azuresky2019/Bacnet_Transducer/DOC/pics/pwm wiring_web.jpg

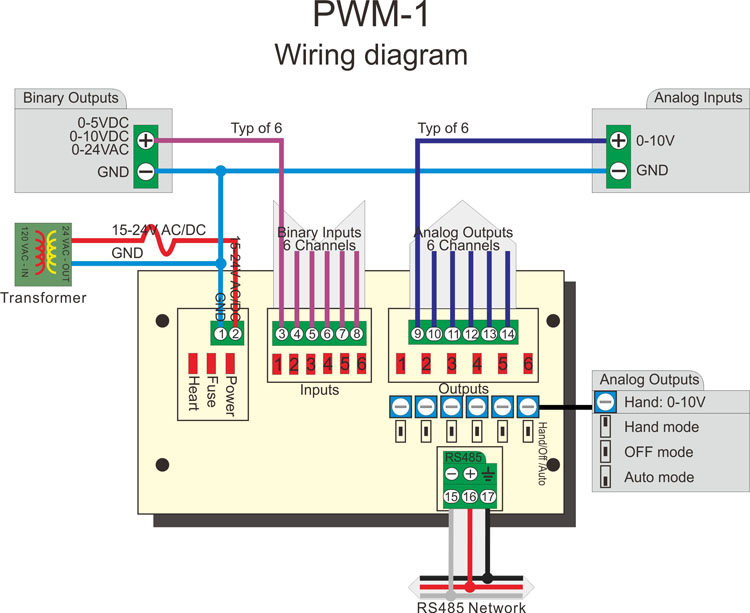
DOC/pics/pwm wiring_web.jpg
