azuresky2019/Bacnet_Transducer/DOC/pics/pwm_web_thumbnail.jpg

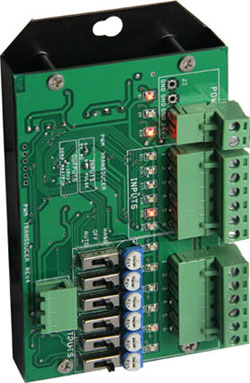
DOC/pics/pwm_web_thumbnail.jpg
