azuresky2019/Bacnet_Transducer/README.md

# Bacnet_Transducer
Bacnet transducer, converts binary output to analog outputs. Also can be used as general purpose Bacnet i/o.
