azuresky2019/Bacnet_Transducer/DOC/pics/2.jpg

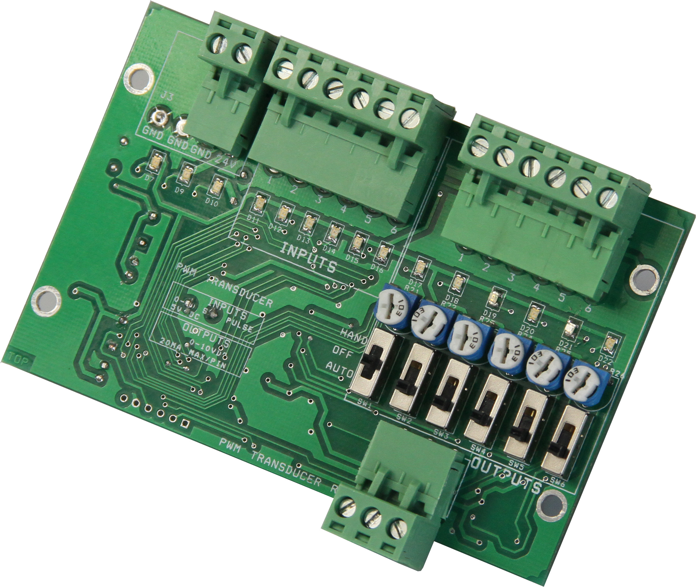
DOC/pics/2.jpg
