azuresky2019/Bacnet_Transducer/DOC/pics/6.jpg

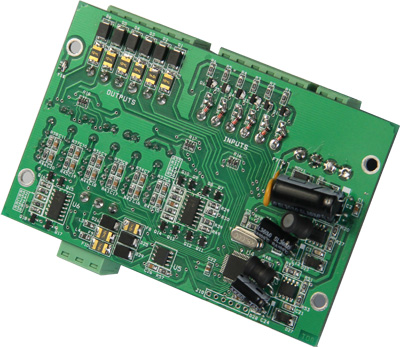
DOC/pics/6.jpg
