azuresky2019/Bacnet_Transducer/DOC/pics/55-2.jpg

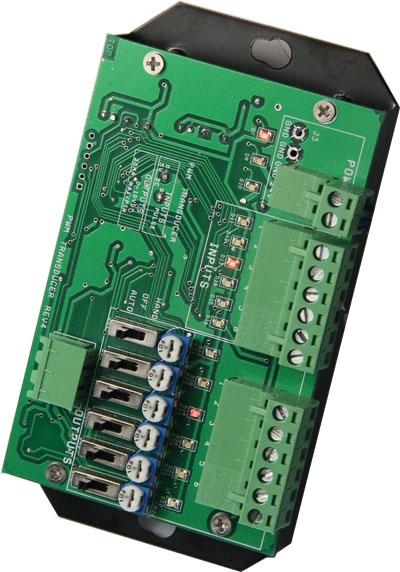
DOC/pics/55-2.jpg
