azuresky2019/Bacnet_Transducer/DOC/pics/PWM0.jpg

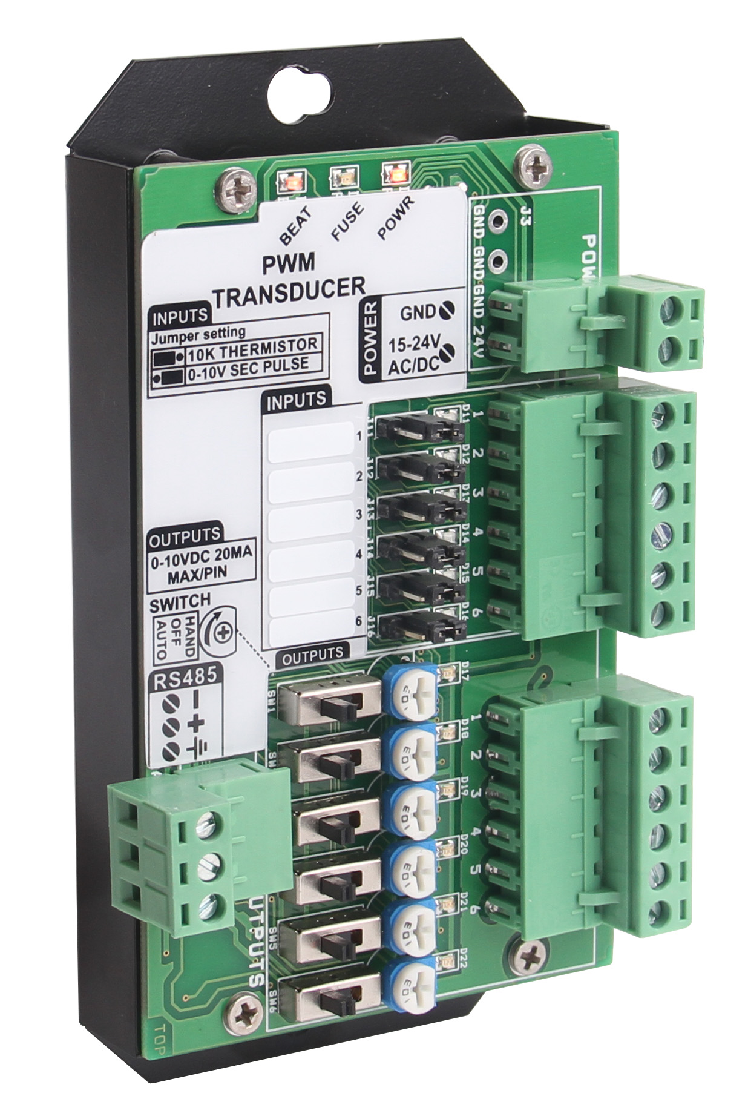
DOC/pics/PWM0.jpg
