azuresky2019/Bacnet_Transducer/DOC/pics/PWM2.jpg

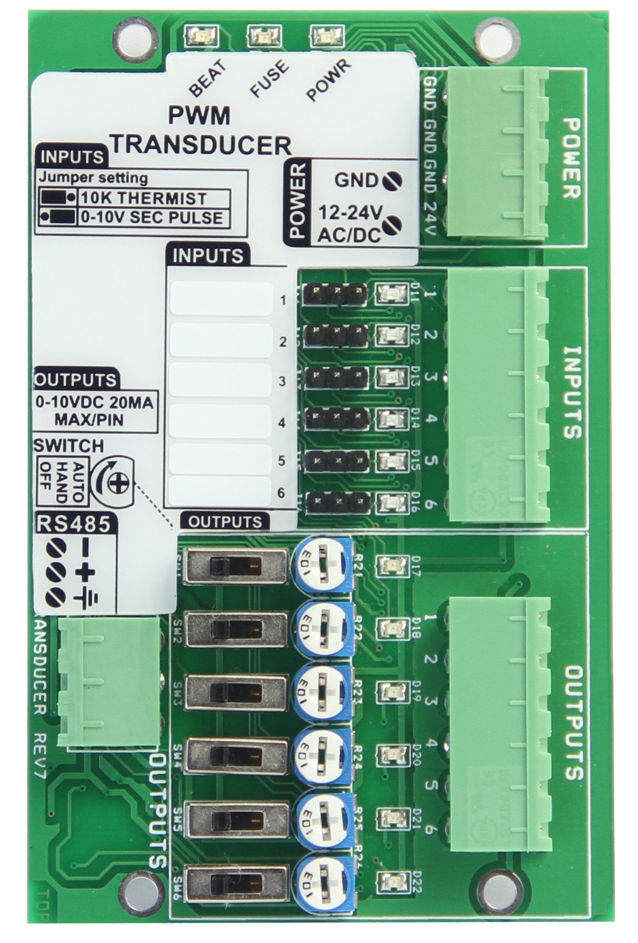
DOC/pics/PWM2.jpg
