azuresky2019/Bacnet_Transducer/DOC/pics/pwm dimensions.jpg

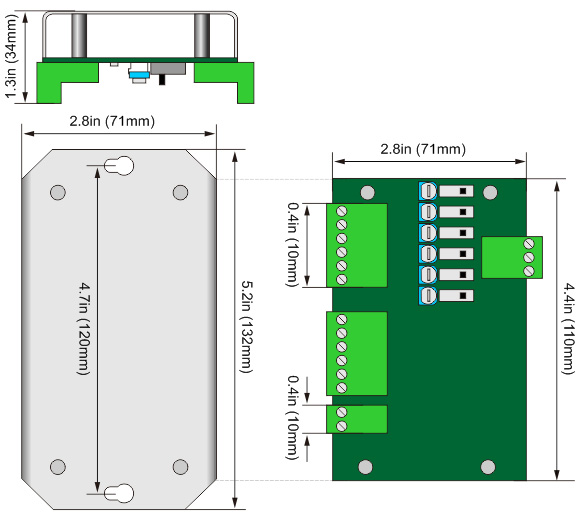
DOC/pics/pwm dimensions.jpg
