azuresky2019/Bacnet_Transducer/DOC/pics/PWM.jpg

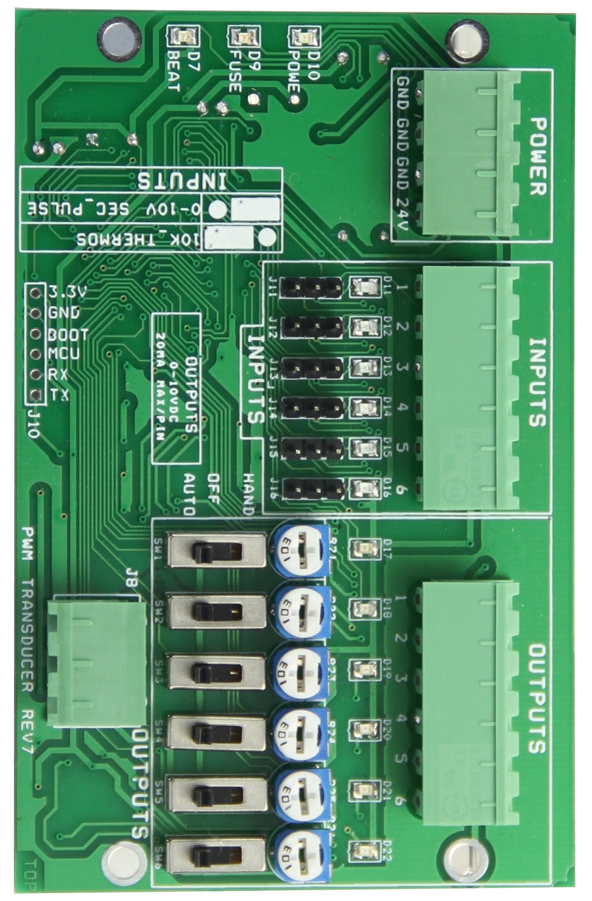
DOC/pics/PWM.jpg
