azuresky2019/Bacnet_Transducer/DOC/pics/PWM_front.jpg

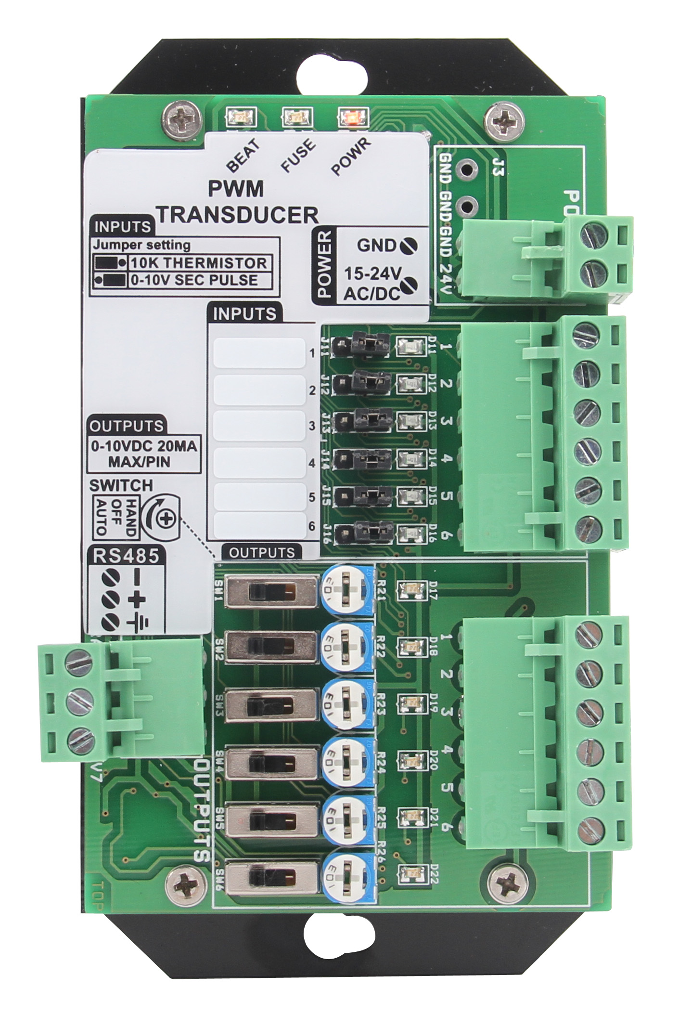
DOC/pics/PWM_front.jpg
