azuresky2019/Bacnet_Transducer/DOC/pics/PWM_left.png

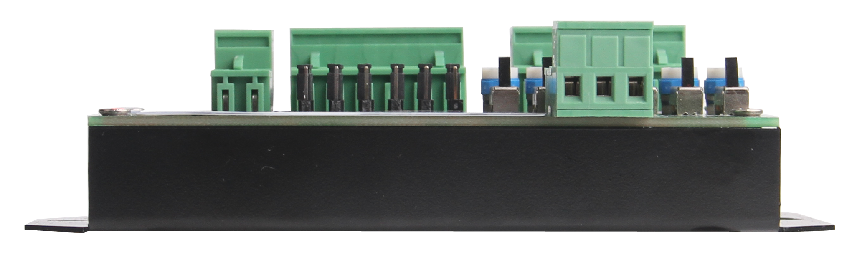
DOC/pics/PWM_left.png
