azuresky2019/Bacnet_Transducer/DOC/pics/PWM_s.png

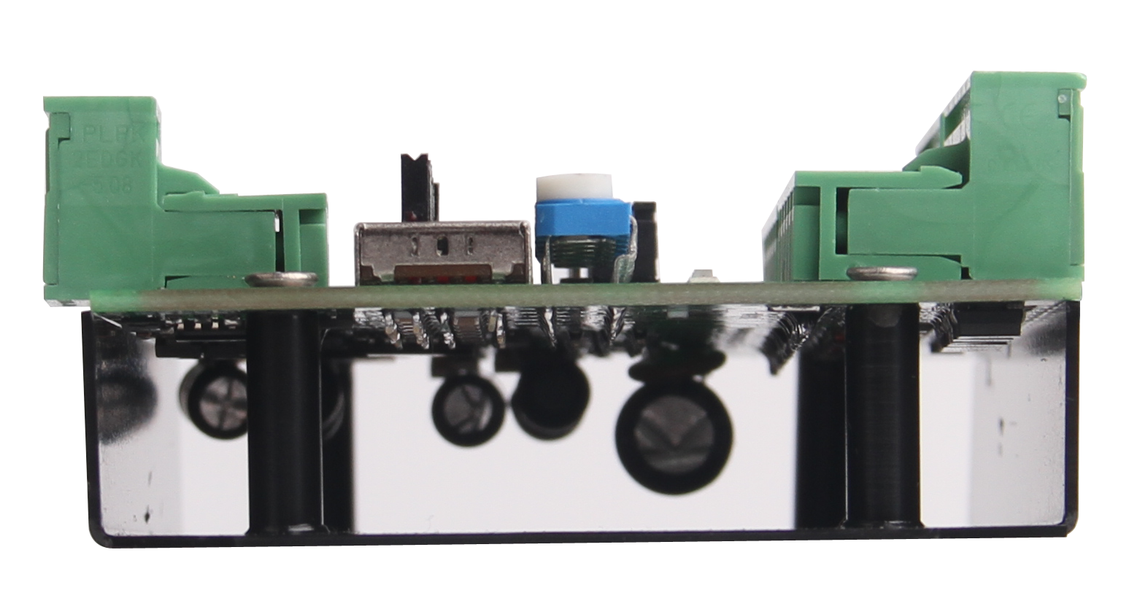
DOC/pics/PWM_s.png
