azuresky2019/Bacnet_Transducer/DOC/pics/PWM_view.jpg

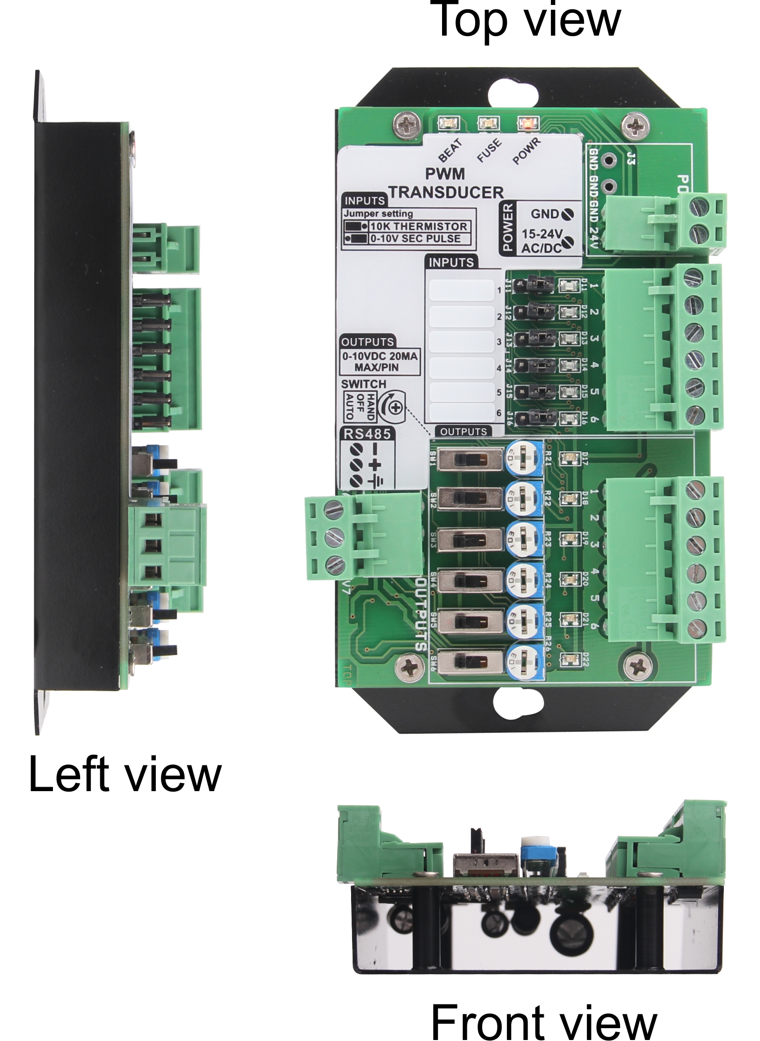
DOC/pics/PWM_view.jpg
