azuresky2019/Bacnet_Transducer/Hardware/PWM_Rev7/PWM_Rev7.xlsx

Z:\Designs\TransducerVolts\Hardware\PWM_Rev7
Bill Of Materials October 17,2016 9:18:17
Itm | Qty | Reference | Value | PCB Footprint | Description | Tle | Part_Number
______________________________________________
1 | 16 | C1,C13,C14,C15,C16,C17,C18,C19, | 0.1UF_50V | SM/C_0805 |  | 10% | 0.1UF_50V_0805
 |  | C20,C23,C26,C27,C28,C29,C30,C33
2 | 1 | C2 | 470UF_50V | CPCYLHORIZ/D.400/LS.200/.034 |  | 20% | 470UF_50V_DIP
3 | 2 | C3,C21 | 220PF_50V | SM/C_0805 |  | 10% | 220PF_50V_0805
4 | 6 | C6,C7,C8,C9,C10,C11 | 1UF_50V | Designs\Lib\CAP.LLB\SM/C_0805 |  | 10% | 1UF_50V_0805
5 | 1 | C12 | 100UF_25V | CPCYLHORIZ/D.200/LS.100/.034 |  | 20% | 100UF_25V_DIP
6 | 1 | C24 | 330UF_16V | CPCYLHORIZ/D.200/LS.100/.034 |  | 20% | 330UF_16V_DIP
7 | 1 | C31 | 10UF_16V | SM/C_TANT |  |  | 10UF_16V_TANT
8 | 1 | C39 | 100UF_7V | SM/C_TANT |  | 10% | 100UF_7V_TANT
9 | 6 | D1,D2,D3,D4,D5,D6 | SMBJ12CA | SM/MOV40V | V(RWM)=12V |  | SMBJ12CA
10 | 8 | D7,D10,D17,D18,D19,D20,D21,D22 | LED_RED_0805 | SM/D_0805_21 |  |  | LED_RED_0805
11 | 1 | D8 | 1N4007 | SM/D_MLL41_21 | VRRM=1000V |  | 1N4007
12 | 1 | D9 | LED_GREEN_0805 | SM/D_0805_21 |  |  | LED_GREEN_0805
13 | 6 | D11,D12,D13,D14,D15,D16 | LED_BLUE_0603 | SM/D_0603 |  |  | LED_BLUE_0603
14 | 2 | D23,D27 | 1N5819 | SM/D_MLL41_21 | V(RMS)=28V |  | 1N5819
15 | 1 | D24 | 1N4744 | SM/D_1206_21 | VZ=15V |  | 1N4744_15V_1206
16 | 3 | D25,D26,D29 | SMBJ10CA | SM/MOV40V | V(RWM)=10V |  | SMBJ10CA
17 | 1 | D28 | 1N4729 | SM/D_1206_21 | VZ=3.6V |  | 1N4729
18 | 6 | D30,D31,D32,D33,D34,D35 | 1N4148 | SM/D_1206 | Fast Switching Diodes |  | 1N4148_1206
19 | 1 | D36 | CJ431_SOT | SM/SOT23_123 | JIANGSU CHANGJIANG |  | CJ431_SOT
20 | 6 | D37,D38,D39,D41,D42,D43 | 1N4729 | SM/D_1206_21 | VZ=3.6V |  | 1N4729
21 | 9 | F1,F2,F3,F4,F5,F6,F8,F9,F10 | 0.1A_60V | SM/FUSE_1812 | MF-MSMF Series - PTC Resettable Fuses |  | MF-MSMF010
22 | 1 | F7 | 0.65A_60V | RAD/.250X.125/LS.200/.034 | LP60 series |  | LP60-065
23 | 1 | J3 | ETB4_5.08_90_GREEN | ETB4INCH | Pitch=5.08mm,single,male,90¡ã,Green,Pluggable |  | ETB4_5.08_90_GREEN
24 | 2 | J4,J5 | ETB6_5.08_90_GREEN | ETB6INCH | Pitch=5.08mm,single,male,90¡ã,Green,Pluggable |  | ETB6_5.08_90_GREEN
25 | 1 | J6 | Tiepoint | GROUNDS_REV1 | solder_metal_wire |  | Tiepoint
26 | 1 | J8 | ETB3_5.08_90_GREEN | ETB3INCH | Pitch=5.08mm,single,male,90¡ã,Green,Pluggable |  | ETB3_5.08_90_GREEN
27 | 1 | J10 | Header6_2.54_180 | HEADER6_2.54 | Pitch=2.54mm, single,male,180¡ã |  | Header6_2.54_180
28 | 6 | J11,J12,J13,J14,J15,J16 | Header3_2.54_180 | HEADER3_2.54 | Pitch=2.54mm, single,male,180¡ã |  | Header3_2.54_180
29 | 2 | L1,L2 | 330uH_1A_SMALL | L/330UH | 0608,1A,330UH |  | 330uH_1A_SMALL
30 | 2 | L3,L4 | 0.3A_1K | SM/C_0805 | 0.3A_1K_100MHZ |  | 0.3A_1K
31 | 1 | L5 | 47uH | SM/L_0805 |  |  | 47uH
32 | 1 | MOV1 | SMBJ36CA | SM/MOV40V | V(RWM)=36V |  | SMBJ36CA
33 | 12 | Q1,Q2,Q3,Q4,Q5,Q6,Q8,Q10,Q12,Q13, | 2N2222 | SM/SOT23_123 |  |  | 2N2222
 |  | Q16,Q18
34 | 6 | Q7,Q9,Q11,Q14,Q15,Q17 | 2N2907 | SM/SOT23_123 |  |  | 2N2907
35 | 24 | R1,R2,R3,R4,R5,R6,R7,R8,R9,R10,R11, | 10K_0805 | SM/R_0805 |  | 1% | 10K_0805
 |  | R12,R65,R66,R67,R68,R69,R70,R71,R72,
 |  | R73,R74,R81,R82
36 | 1 | R13 | 470R_0805 | SM/R_0805 |  | 1% | 470R_0805
37 | 3 | R14,R15,R89 | 1K_0805 | SM/R_0805 |  | 1% | 1K_0805
38 | 3 | R16,R17,R18 | 200R_4P | SM/R_1608_NET4 |  |  | 200R_4P
39 | 2 | R19,R47 | 0.5R_1206 | SM/R_1206 |  | 1% | 0.5R_1206
40 | 1 | R20 | 16.9K_0805 | SM/R_0805 |  | 1% | 16.9K_0805
41 | 6 | R21,R22,R23,R24,R25,R26 | 10K_VAR |  | 3pins£¬10K VAR ,VC1000 |  | 10K_VAR
42 | 1 | R27 | 1.96K_0805 | SM/R_0805 |  | 1% | 1.96K_0805
43 | 6 | R29,R32,R49,R50,R52,R58 | 6.19K_0805 | SM/R_0805 |  | 1% | 6.19K_0805
44 | 6 | R30,R31,R39,R40,R54,R56 | 3K_0805 | SM/R_0805 |  | 1% | 3K_0805
45 | 7 | R33,R34,R35,R36,R37,R38,R57 | 4.7K_0805 | SM/R_0805 |  | 1% | 4.7K_0805
46 | 6 | R41,R42,R43,R44,R45,R46 | 47K_0805 | SM/R_0805 |  | 1% | 47K_0805
47 | 1 | R51 | 5.9K_0805 | SM/R_0805 |  | 1% | 5.9K_0805
48 | 1 | R53 | 3.6K_0805 | SM/R_0805 |  | 1% | 3.6K_0805
49 | 6 | R59,R60,R61,R62,R63,R64 | 200K_0805 | SM/R_0805 |  | 1% | 200K_0805
50 | 3 | R83,R85,R87 | 100K_0805 | SM/R_0805 |  |  | 100K_0805
51 | 1 | R84 | 0R_0805 | SM/R_0805 |  |  | 0R_0805
52 | 1 | R88 | 1.5K_2010 | SM/R_0805 | 1/2W | 1% | 1.5K_2010
53 | 1 | R90 | 4.99K_0805 | SM/R_0805 |  |  | 4.99K_0805
54 | 3 | R91,R92,R93 | 10K_0805 | SM/R_0805 |  |  | 10K_0805
55 | 6 | SW1,SW2,SW3,SW4,SW5,SW6 | SW DP3T_4 | SWSLIDESP3TC_NO_POSTHOLE | T3_8I13R_Switch |  | SW DP3T_4
56 | 2 | U1,U3 | MC34063A_SO | 8SOP150 |  |  | MC34063A_SO
57 | 2 | U2,U6 | LM324DR | 14SOP150 |  |  | LM324DR
58 | 1 | U4 | STM32F103VC | QUAD.50M/100/WG16.00 | 100PINs£¬small STM32 chip |  | STM32F103VC
59 | 1 | U5 | SN65HVD3082 | 8SOP150 |  |  | SN65HVD3082
60 | 1 | U7 | AT24C16 | 8SOP150 |  |  | AT24C16
61 | 1 | X1 | 8MHZ_SMD_3PIN | 8M_SMD_3PIN | SMD |  | 8MHZ_SMD_3PIN
