azuresky2019/Bacnet_Transducer/Hardware/PWM_Rev6/pwmrev6_1012.dxf

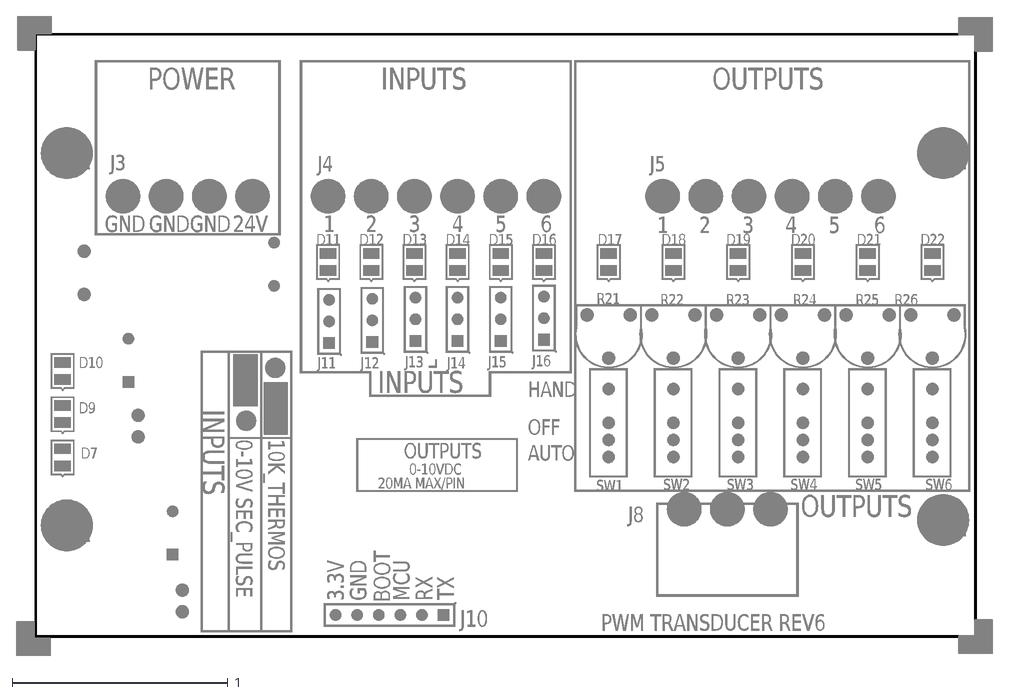
[picture p26: CAD file, 2017-04-28, an earlier design]
Hardware/PWM_Rev6/pwmrev6_1012.dxf
INPUTS
OUTPUTS
POWER
GND
24V
1
2
3
4
5
6
3.3V
AUTO
HAND
OFF
10K_THERMOS
RX
0-10VDC
20MA MAX/PIN
0-10V SEC_PULSE
PWM TRANSDUCER REV6
J2
J9
J1
J7
D17
D9
D15
D22
D13
R21
D20
J5
D11
R25
SW1
D18
SW2
R23
D16
D7
R22
D14
SW3
R24
SW5
SW4
D10
J8
J4
J3
D12
SW6
R26
D19
D21
J11
J12
J13
J14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
