azuresky2019/Bacnet_Transducer/(list of files, cad)

Other CAD files:
Hardware/PWM_Rev5/PWMREV5.dxf
