azuresky2019/Bacnet_Transducer/Hardware/PWM_Rev7/pwmrev6.pdf

## RTC POWER

## MCU DEBUG PORT

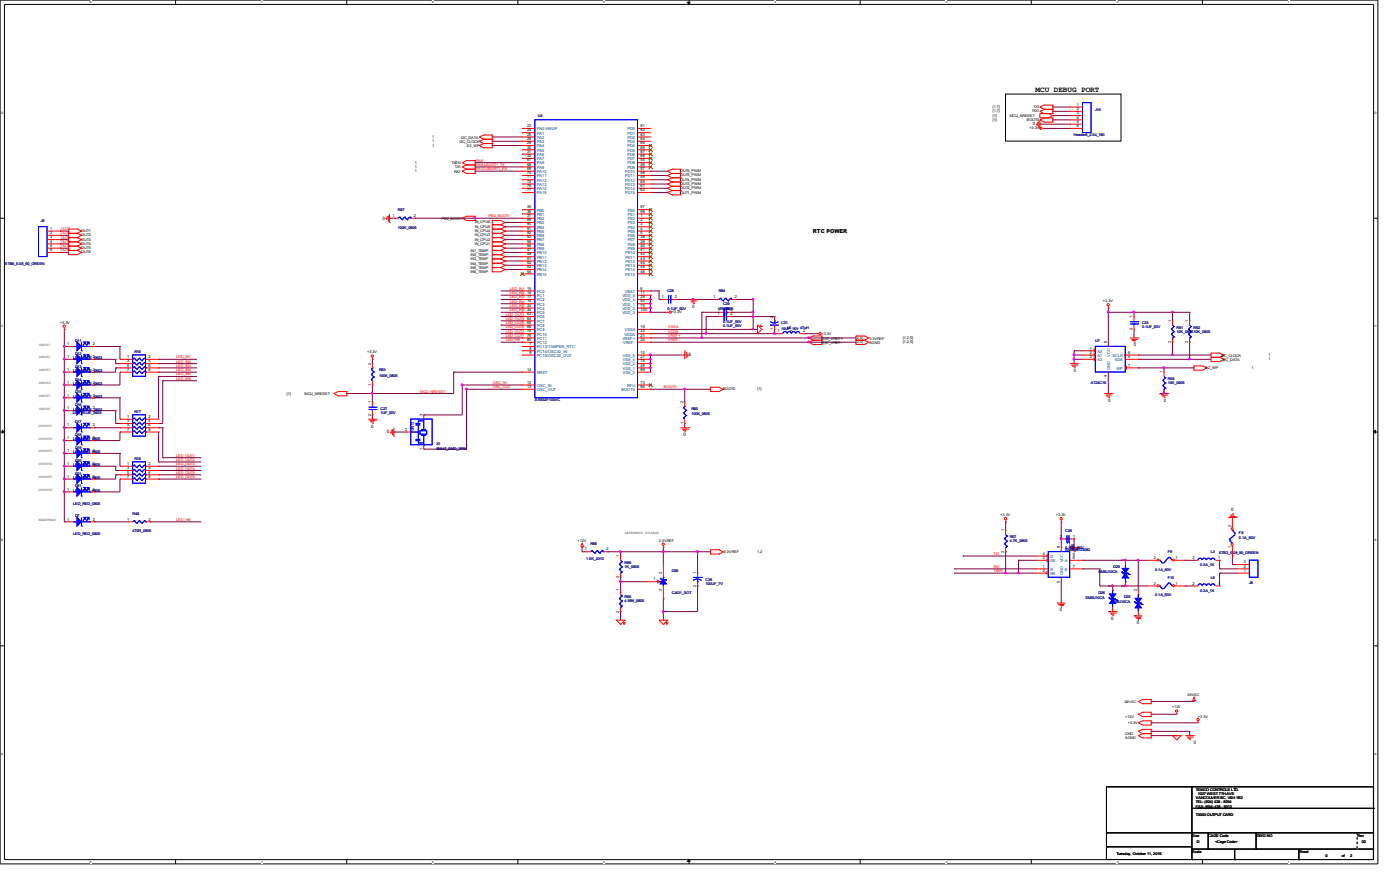
[picture p27: page 1]

5

4

3

2

1

E | E
D | D
C | C
B | B
A | A

# Original Rev for Memco

# Rev0

# Took T3-8I8O design rev14 and reworked it for PWM project

# Rev1

# Done: fix mux select lines

# Done: remove pull up on P0 lines

# Done: require a TXEN line for RS485 com, pin3.2

# Done: remove 470 current limitting resistors

# Done: move D33 to make space for pic socket

# Done: R18 and R22 to move for cpu socket

# Done: update footprint of packet resistors

# Done: flip D33

# Done: move IN_CPU2 to Port0 given the internal pull-ups may affect Analog input reads

# Done: output feedback to pic should come from 5V side of OPamp

Done: One pin of each "hand" potentiometer must be tied to GND.

# Done: Each "hand" potentiometer must be tied to 12V not 5V

# Done: Connect analog GND to INPUT page

# Done: Make sure all thru-holes have thermal relief

# Done: Outputs out of order on PCB

# Done: crystal footprint updated

# Done: changed the resistance for power to 1.89 and 5.96 for the 5V supply

# TBD: rectify footprint names of 2N2222, Q1, Q2 for BOM purposes

# Done: timing cap for power chip changed to 120pF to reduce noise

# Rev2

# Done: changed jumper select to switches

# Done: added diode to decrease 5V line for 485 module, it would overheat otherwise

# Rev3

# Done: fix footprint of switches

# Done: change cap by op-amp to 10uF. 100uF too slow

# Done: rectify connection with Input Con. Was mis-labelled

# Slick Screen on Board was mislabelled. Still reads Rev2

# note: make sure muxes are phillips brand. Does not work with Texas chips

# Rev5

# Done:R56,R58丝印错误

# Title

Size | Document Number | Rev
Date: | Sheet | of
| <Doc> | <RevCode>

# <Title>

B

Monday, April 13, 2015 | 1 | 1

# Title

Size | Document Number | Rev
Date: | Sheet | of
| <Doc> | <RevCode>

# <Title>

B

Monday, April 13, 2015 | 1 | 1

# Title

Size | Document Number | Rev
Date: | Sheet | of
| <Doc> | <RevCode>

# <Title>

B

Monday, April 13, 2015 | 1 | 1

# IN_CPU1

# IN_CPU2

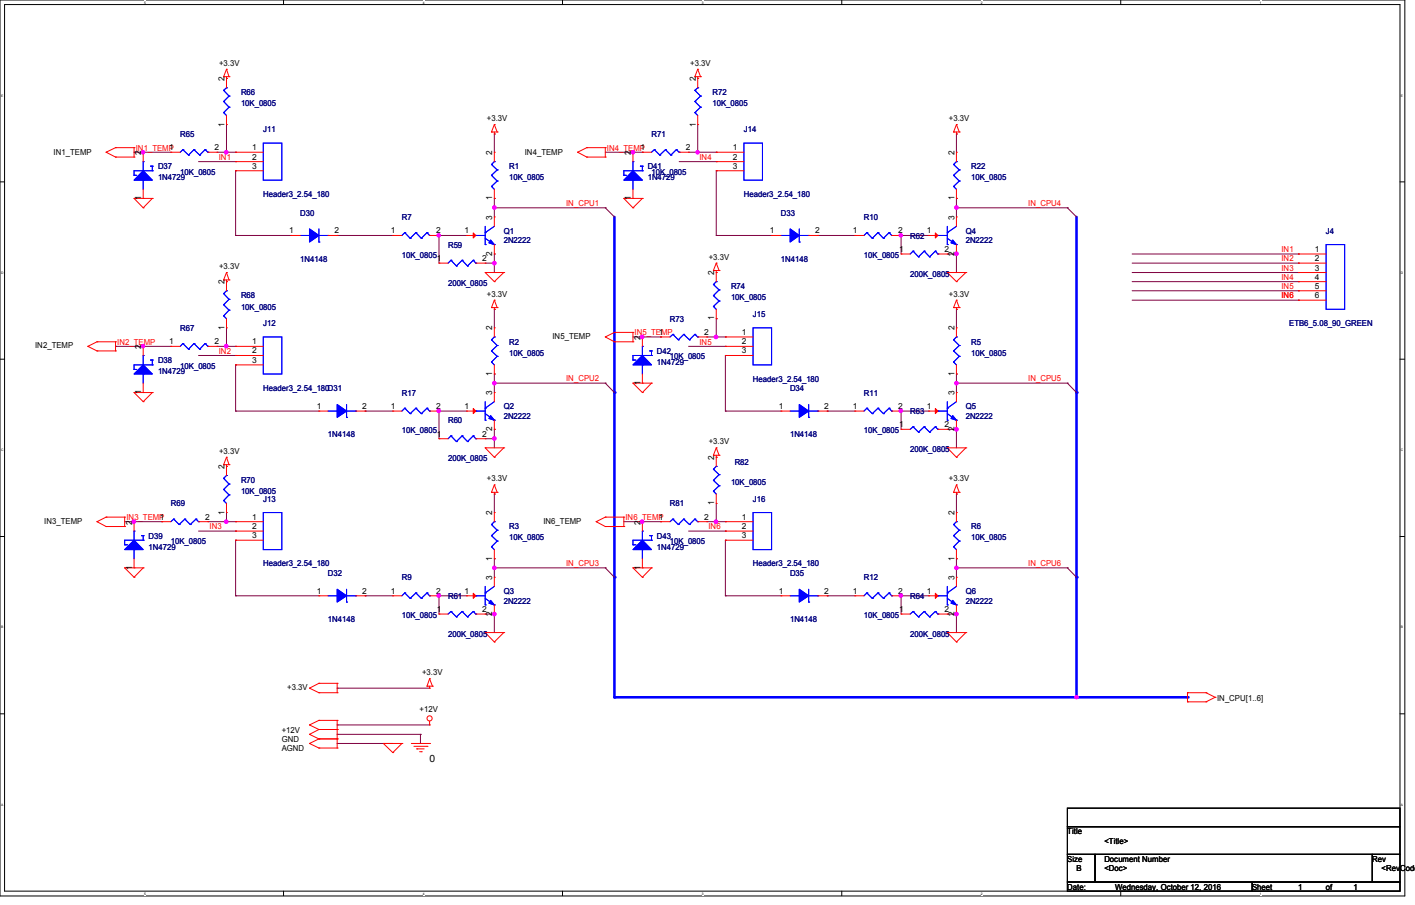
[picture p28: page 3]

# OUT1

# OUT2

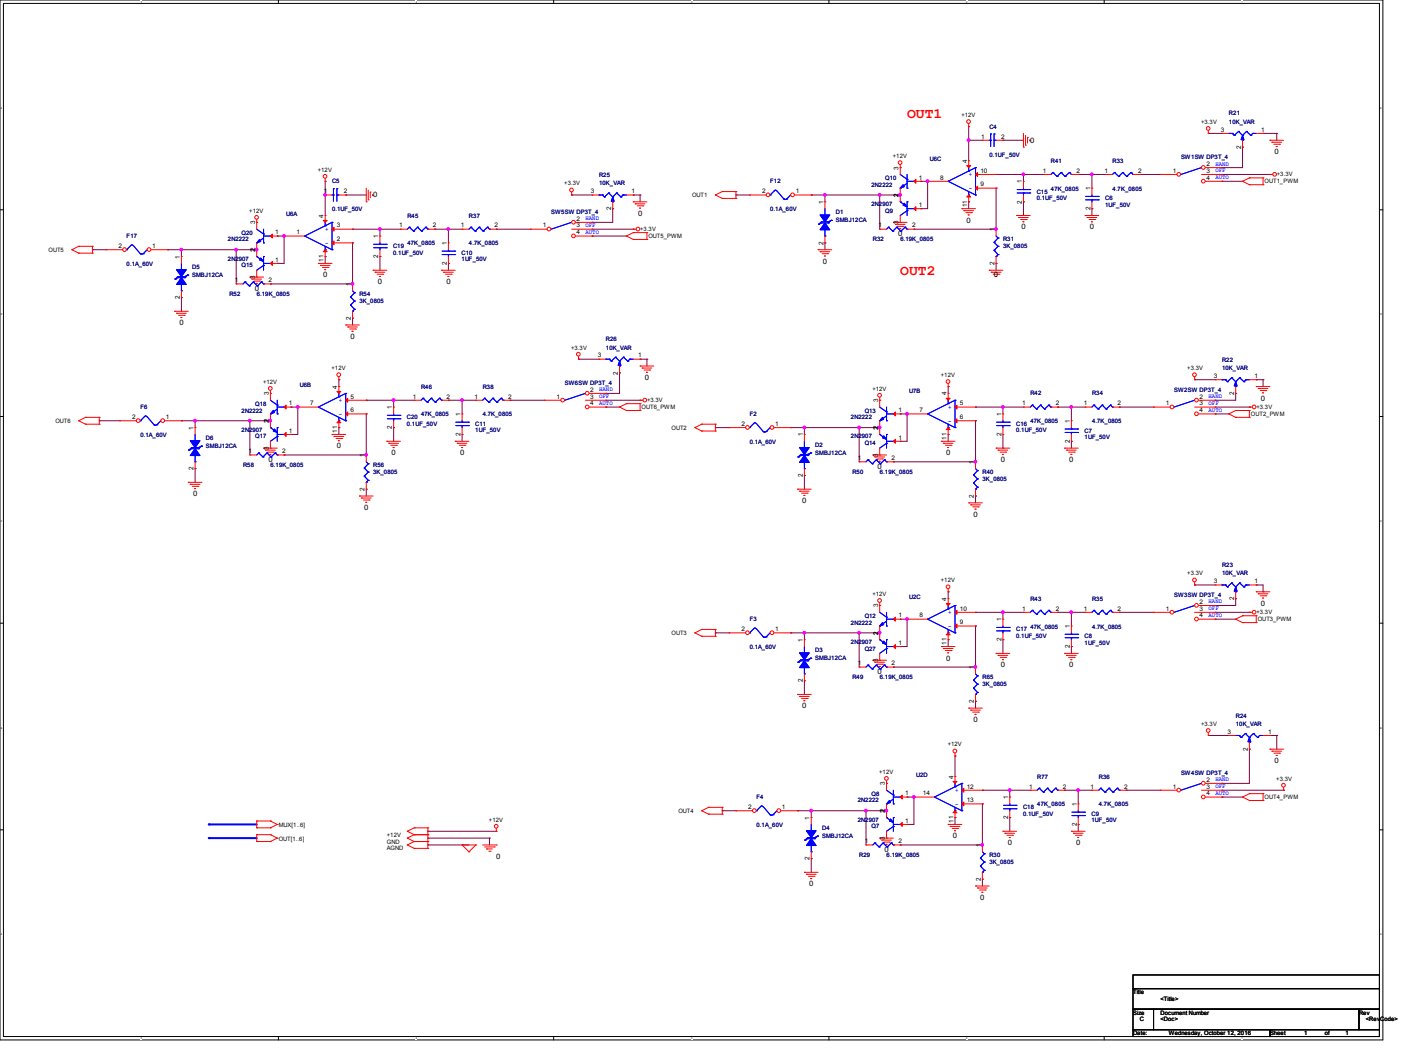
[picture p29: page 4]

# POWER

0

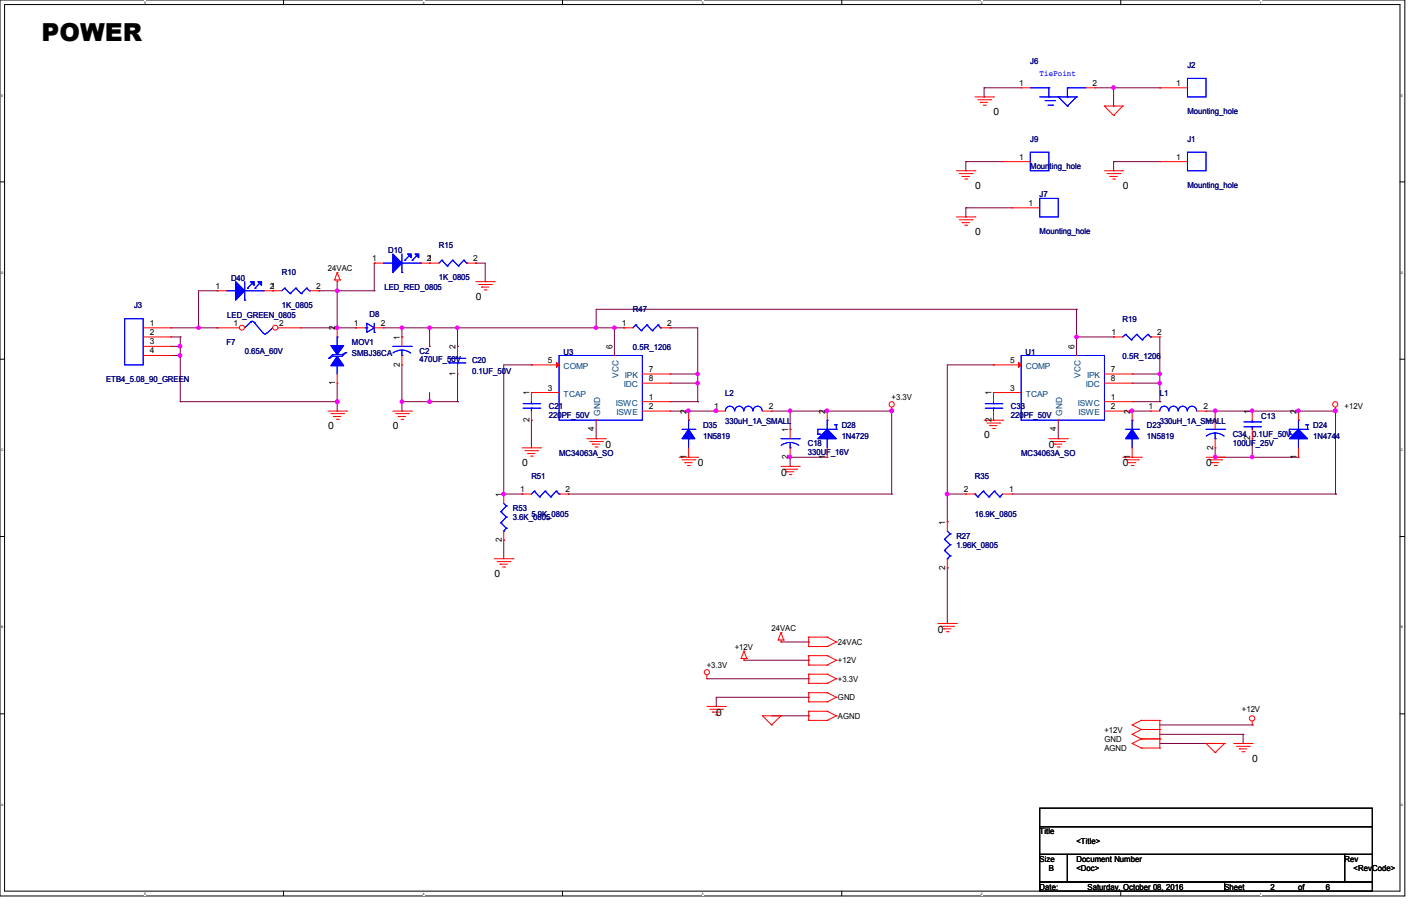
[picture p30: page 5]
