azuresky2019/Bacnet_Transducer/Hardware/PWM_Rev7/pwmrev7.pdf

## RTC POWER

## MCU DEBUG PORT

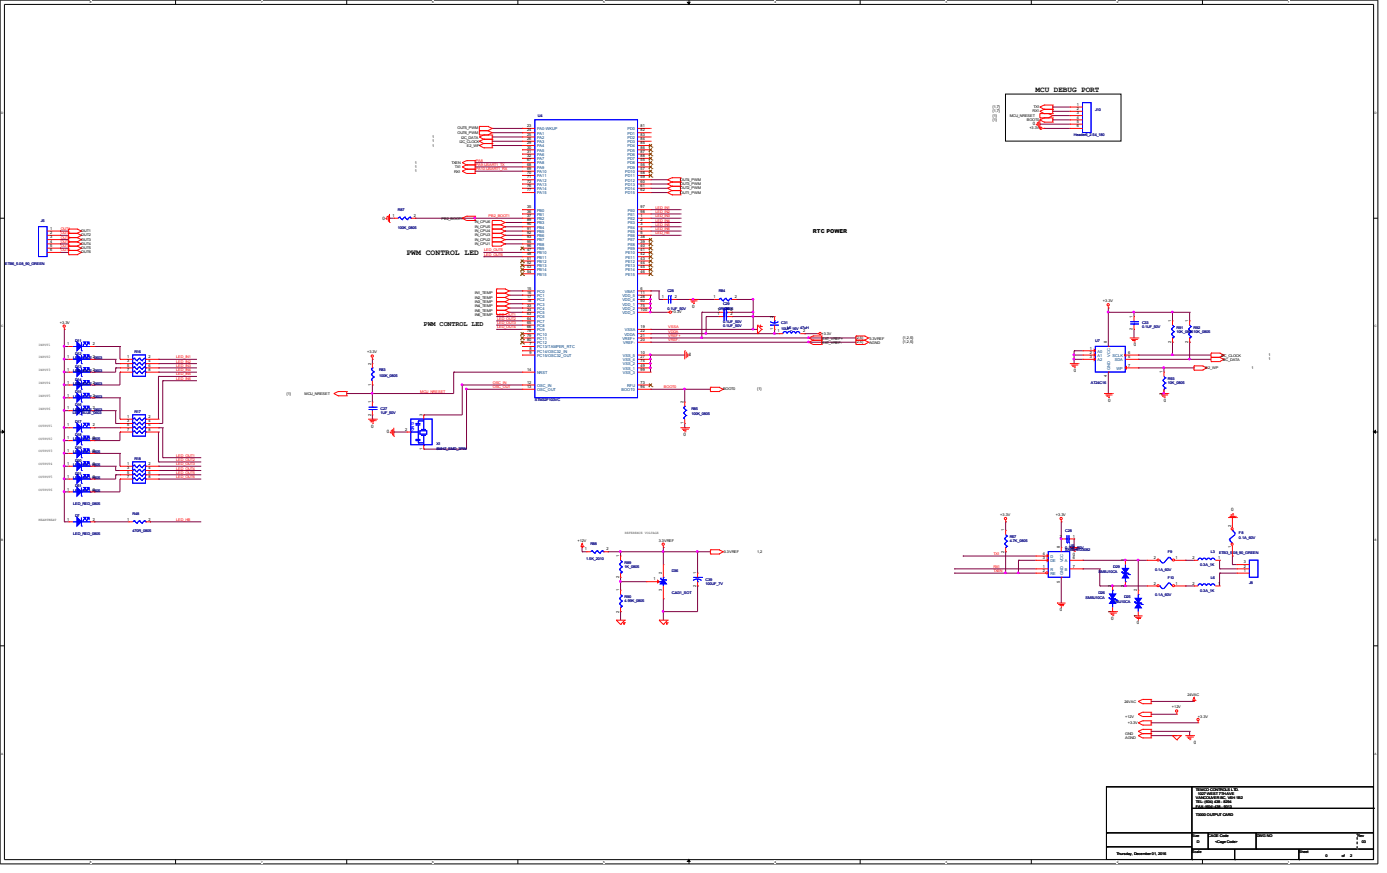
[picture p31: page 1]
