azuresky2019/Bacnet_Transducer/Hardware/PWM_Rev2/pwmrev2.pdf

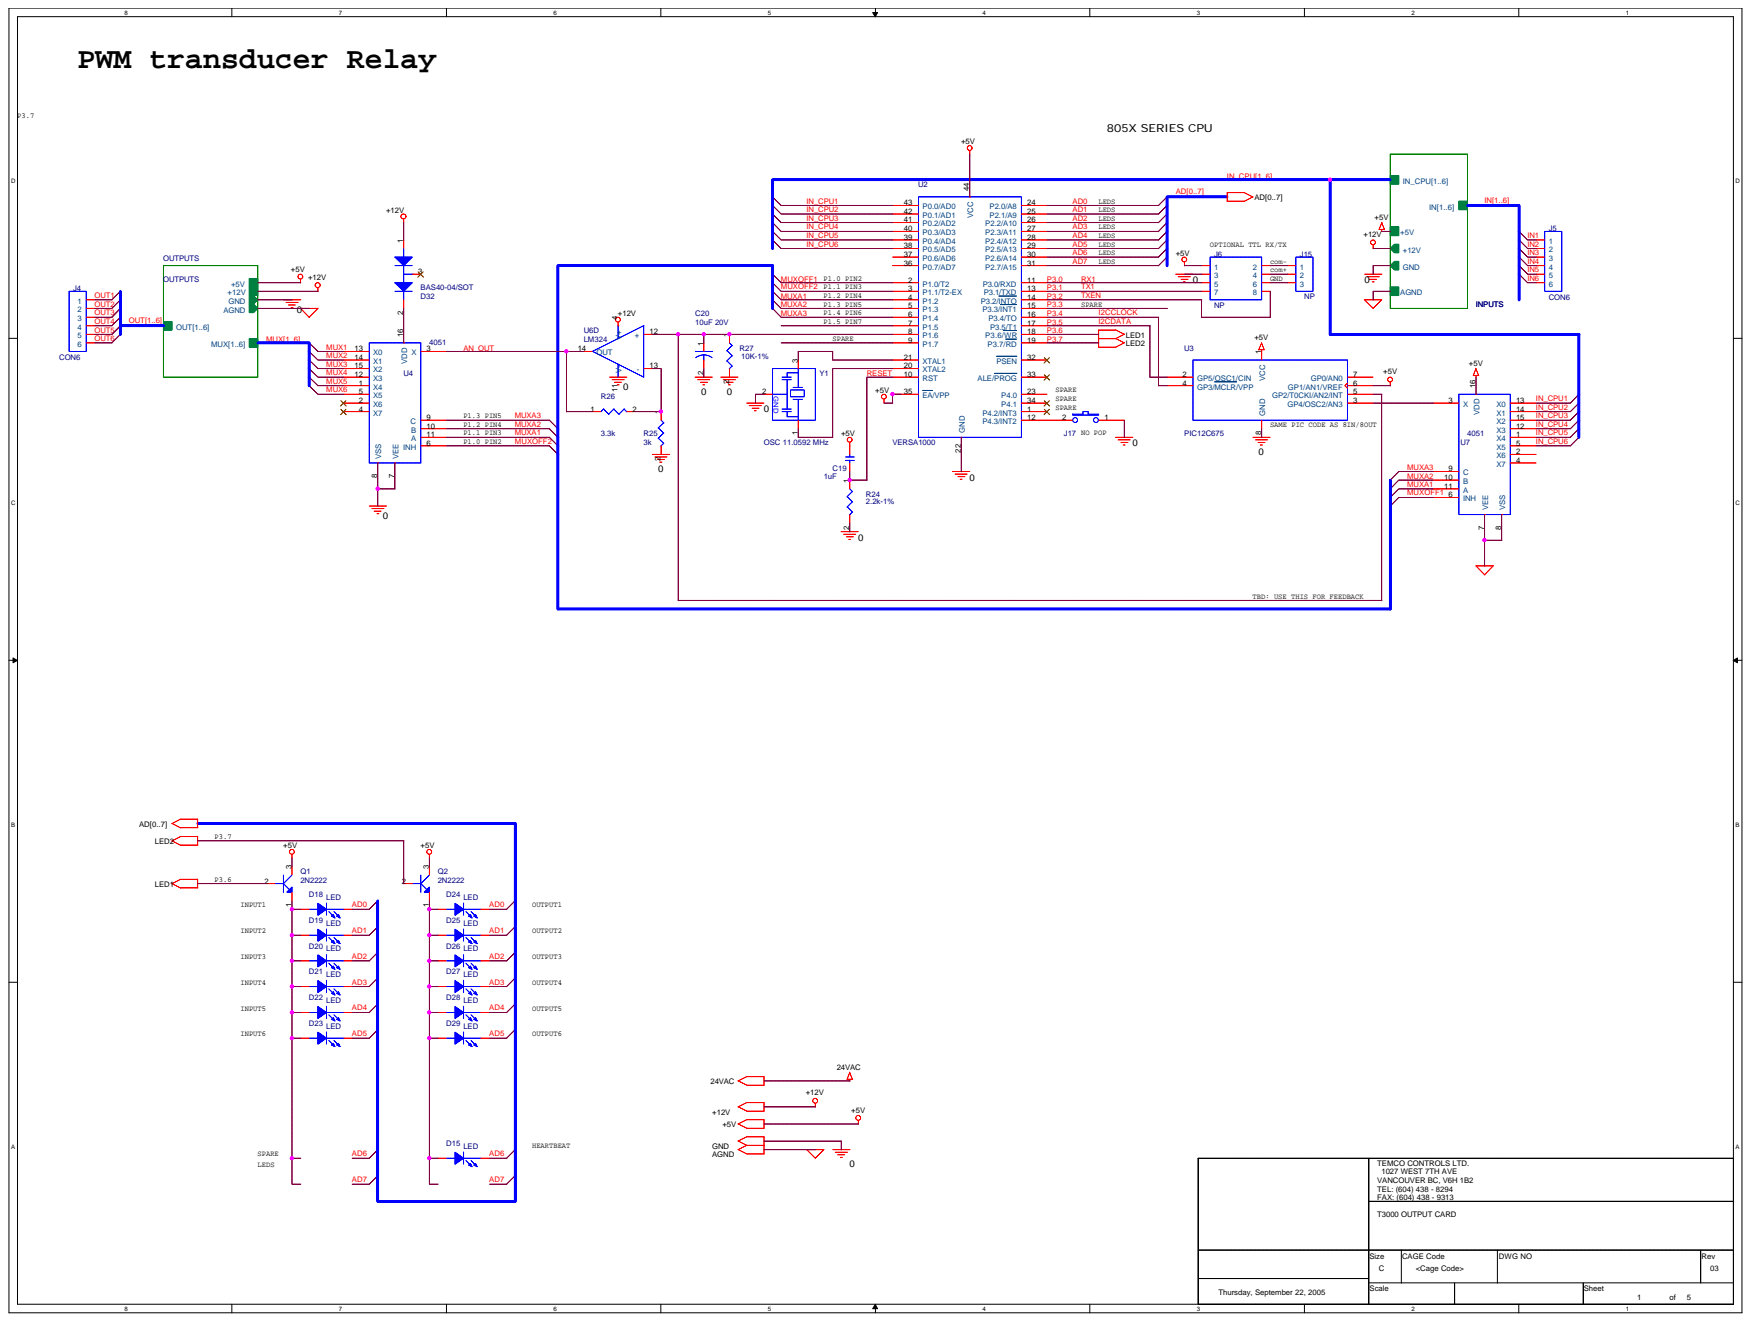
[picture p32: page 1]

SAME PIC CODE AS 8IN/8OUT

TBD: USE THIS FOR FEEDBACK

Size C | CAGE Code <Cage Code> | DWG NO | Rev

Thursday, September 22, 2005 | Scale | | Sheet 1 5 of

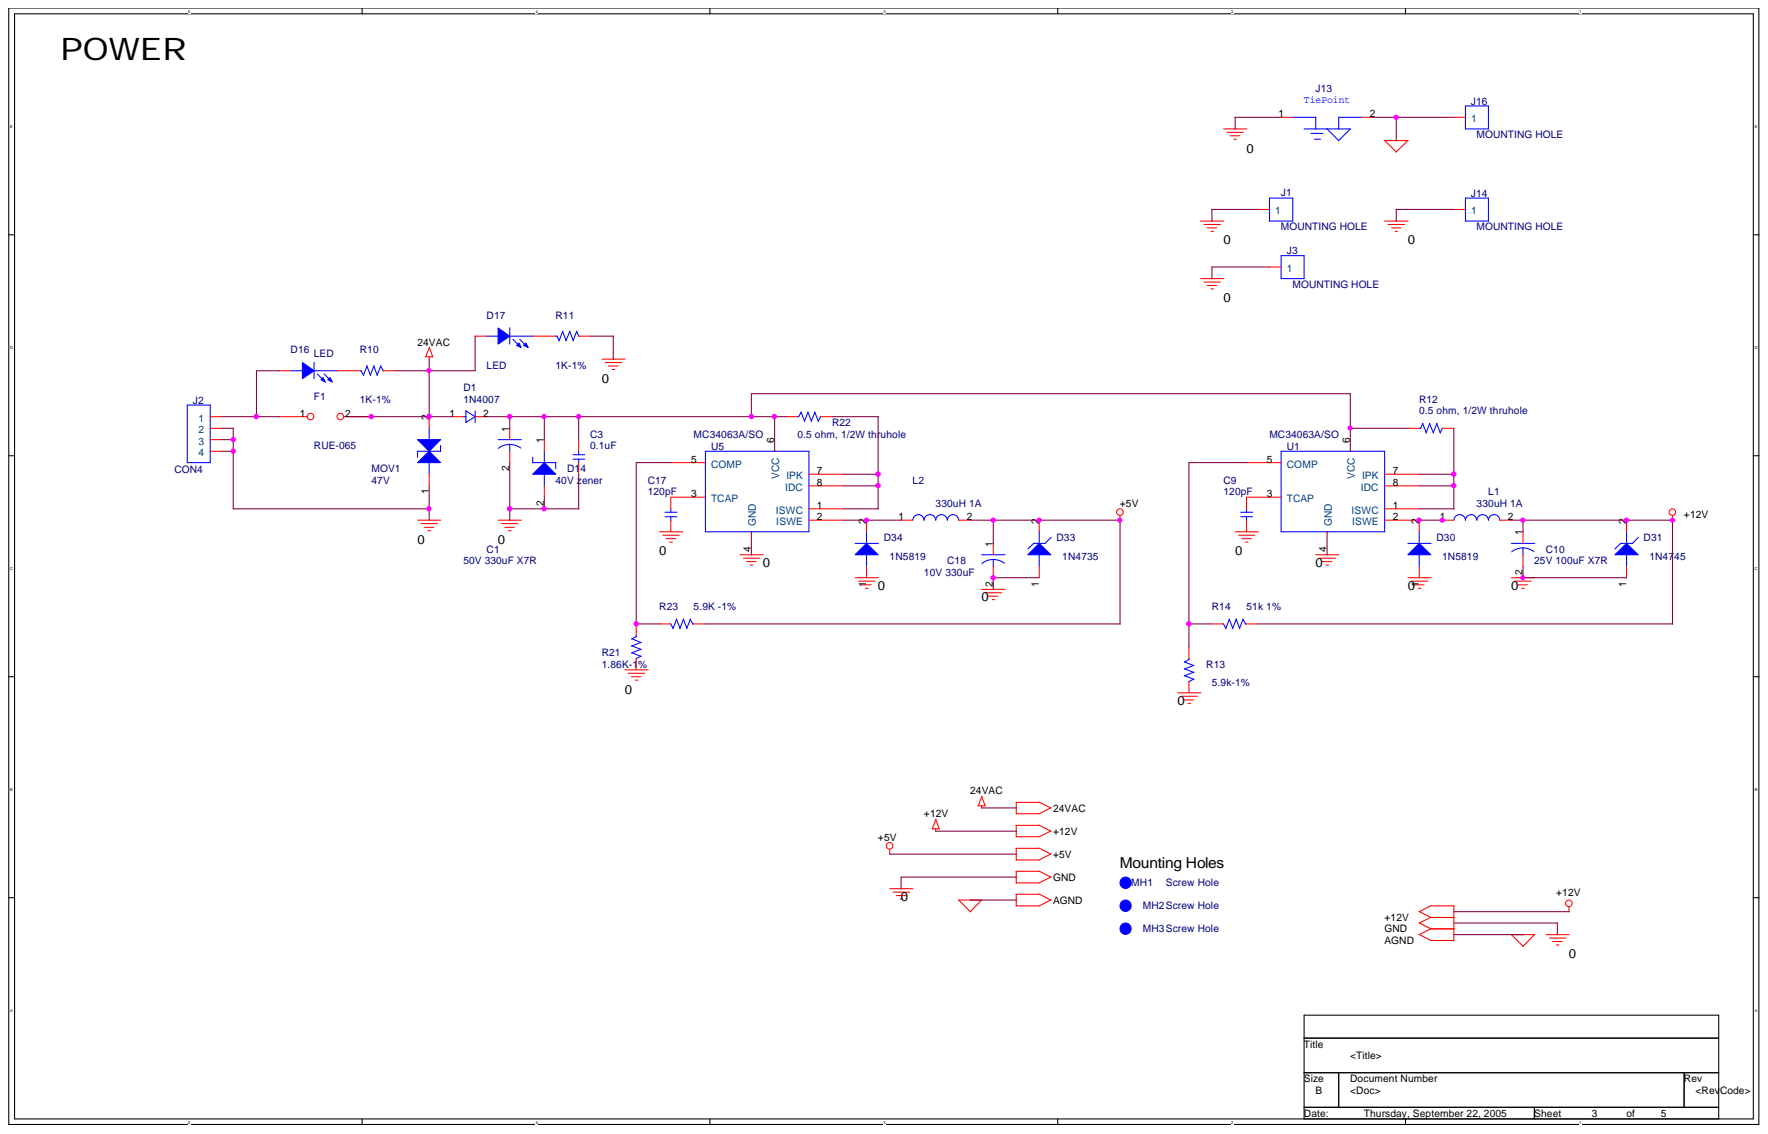
[picture p33: page 2]

Size B | Document Number | Rev

Date: Thursday, September 22, 2005 | Sheet 3 of 5

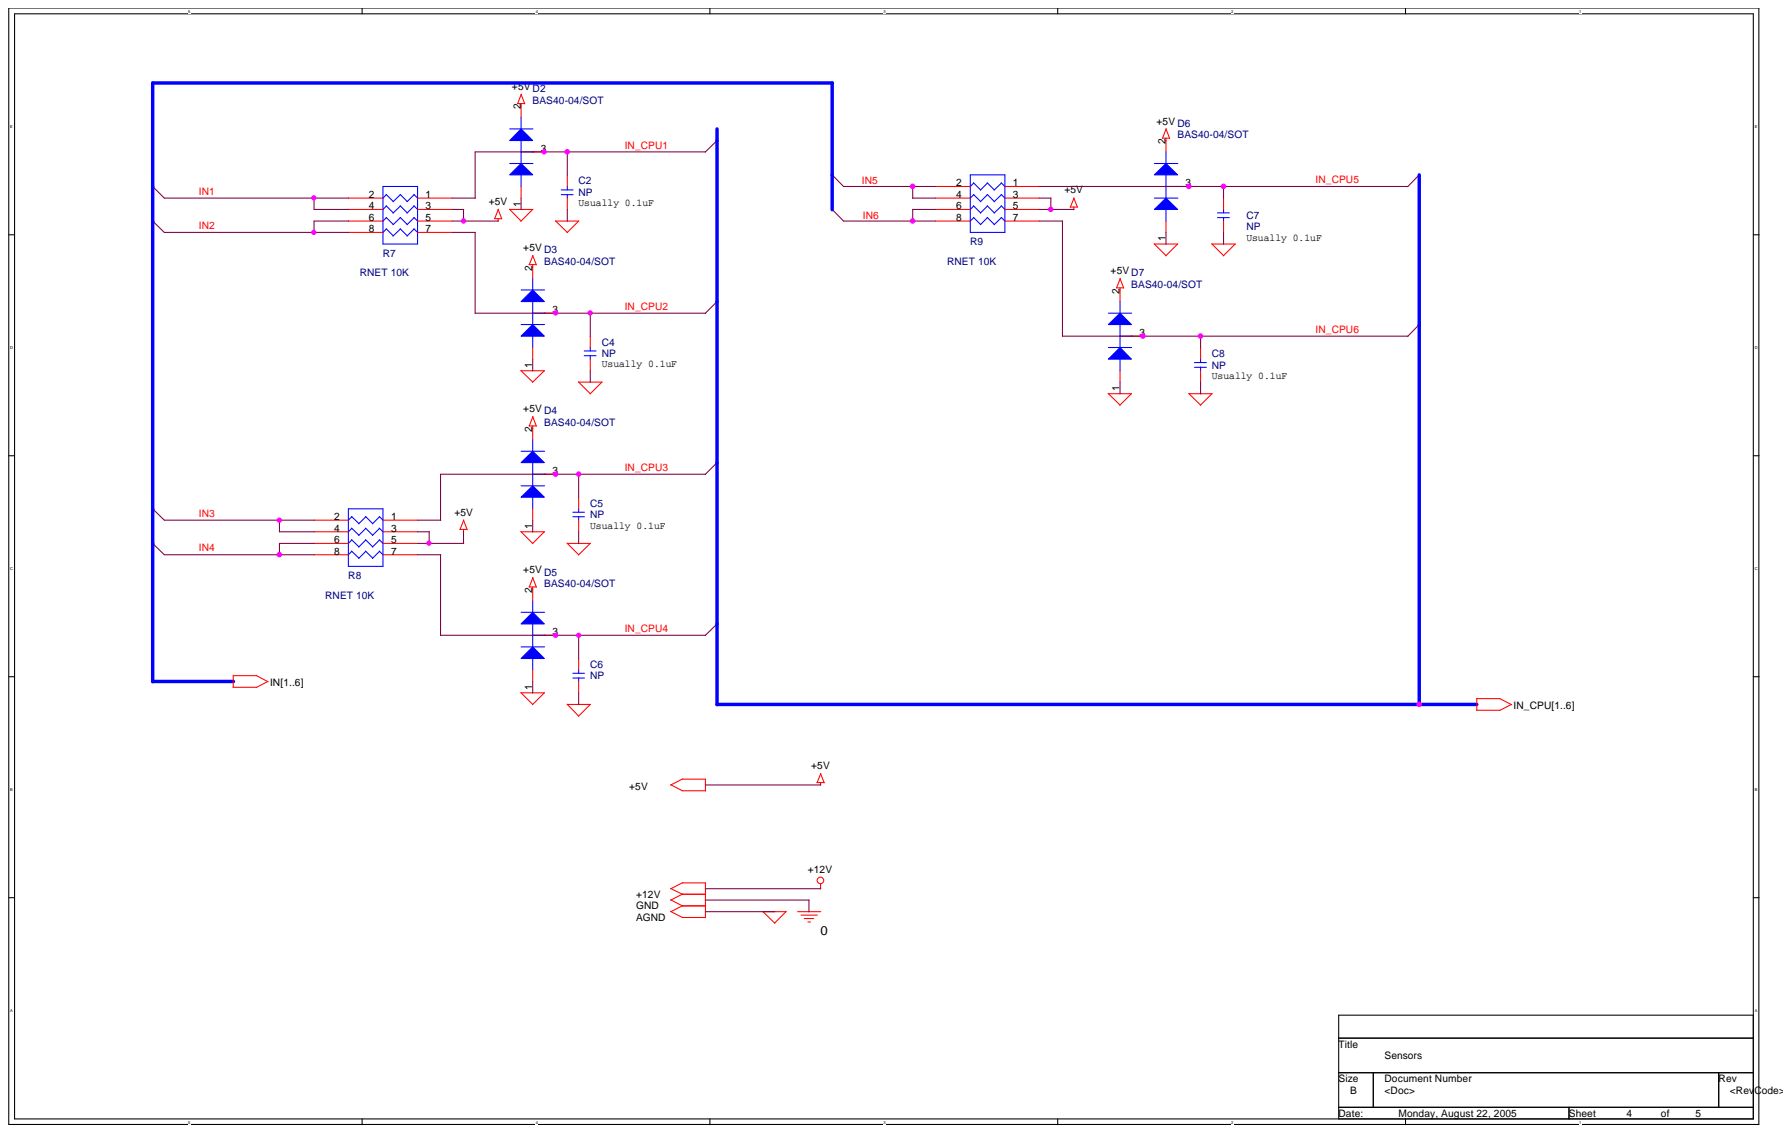
[picture p34: page 3]

Size B | Document Number | Rev

Date: Monday, August 22, 2005 | Sheet 4 of 5

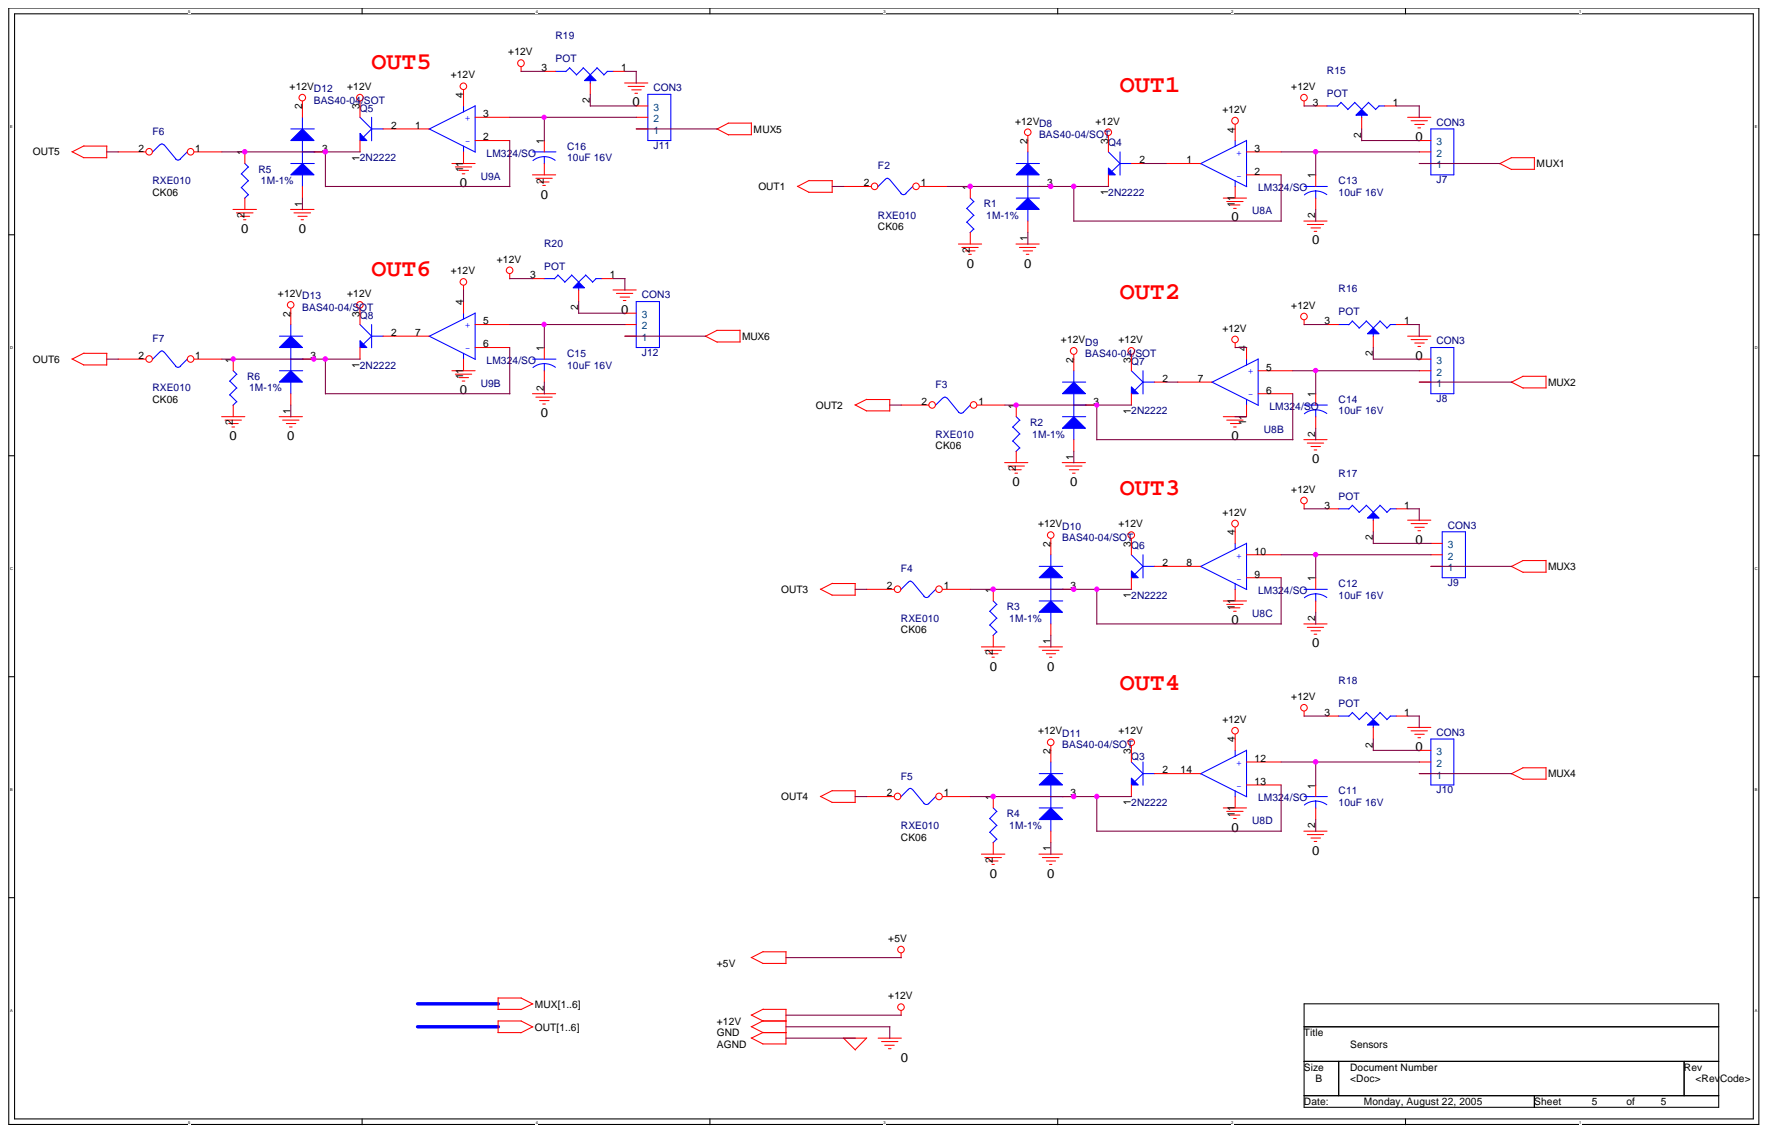
[picture p35: page 4]

Size B | Document Number | Rev

Date: Monday, August 22, 2005 | Sheet 5 of 5

5

4

3

2

1

E | E
D | D
C | C
B | B
A | A

# Original Rev for Memco

# Rev0

# Took T3-8I8O design rev14 and reworked it for PWM project

# Rev1 Done: fix mux select lines

# Done: remove pull up on P0 lines

# Done: require a TXEN line for RS485 com, pin3.2 Done: remove 470 current limitting resistors

# Done: move D33 to make space for pic socket

# Done: R18 and R22 to move for cpu socket

# Done: update footprint of packet resistors

# Done: flip D33

# Done: move IN_CPU2 to Port0 given the internal pull-ups may affect Analog input reads

# Done: output feedback to pic should come from 5V side of OPamp

Done: One pin of each "hand" potentiometer must be tied to GND.

# Done: Each "hand" potentiometer must be tied to 12V not 5V Done: Connect analog GND to INPUT page

# Done: Make sure all thru-holes have thermal relief

# Done: Outputs out of order on PCB

# Done: crystal footprint updated

# Done: changed the resistance for power to 1.89 and 5.96 for the 5V supply

# TBD: rectify footprint names of 2N2222, Q1, Q2

# Done: timing cap for power chip changed to 120pF to reduce noise

# Rev2

# MD: put back current limitting resistors on outputs, 470R

# Rev3 (Not built yet)

<Doc> | <RevCode>

## <Title>

Size B | Document Number | Rev
Date: Thursday, September 22, 2005 | Sheet 2 of 5

## Title
