azuresky2019/Bacnet_Transducer/Hardware/PWM_Rev4/pwmrev4.pdf

IN1

## IN_CPU1

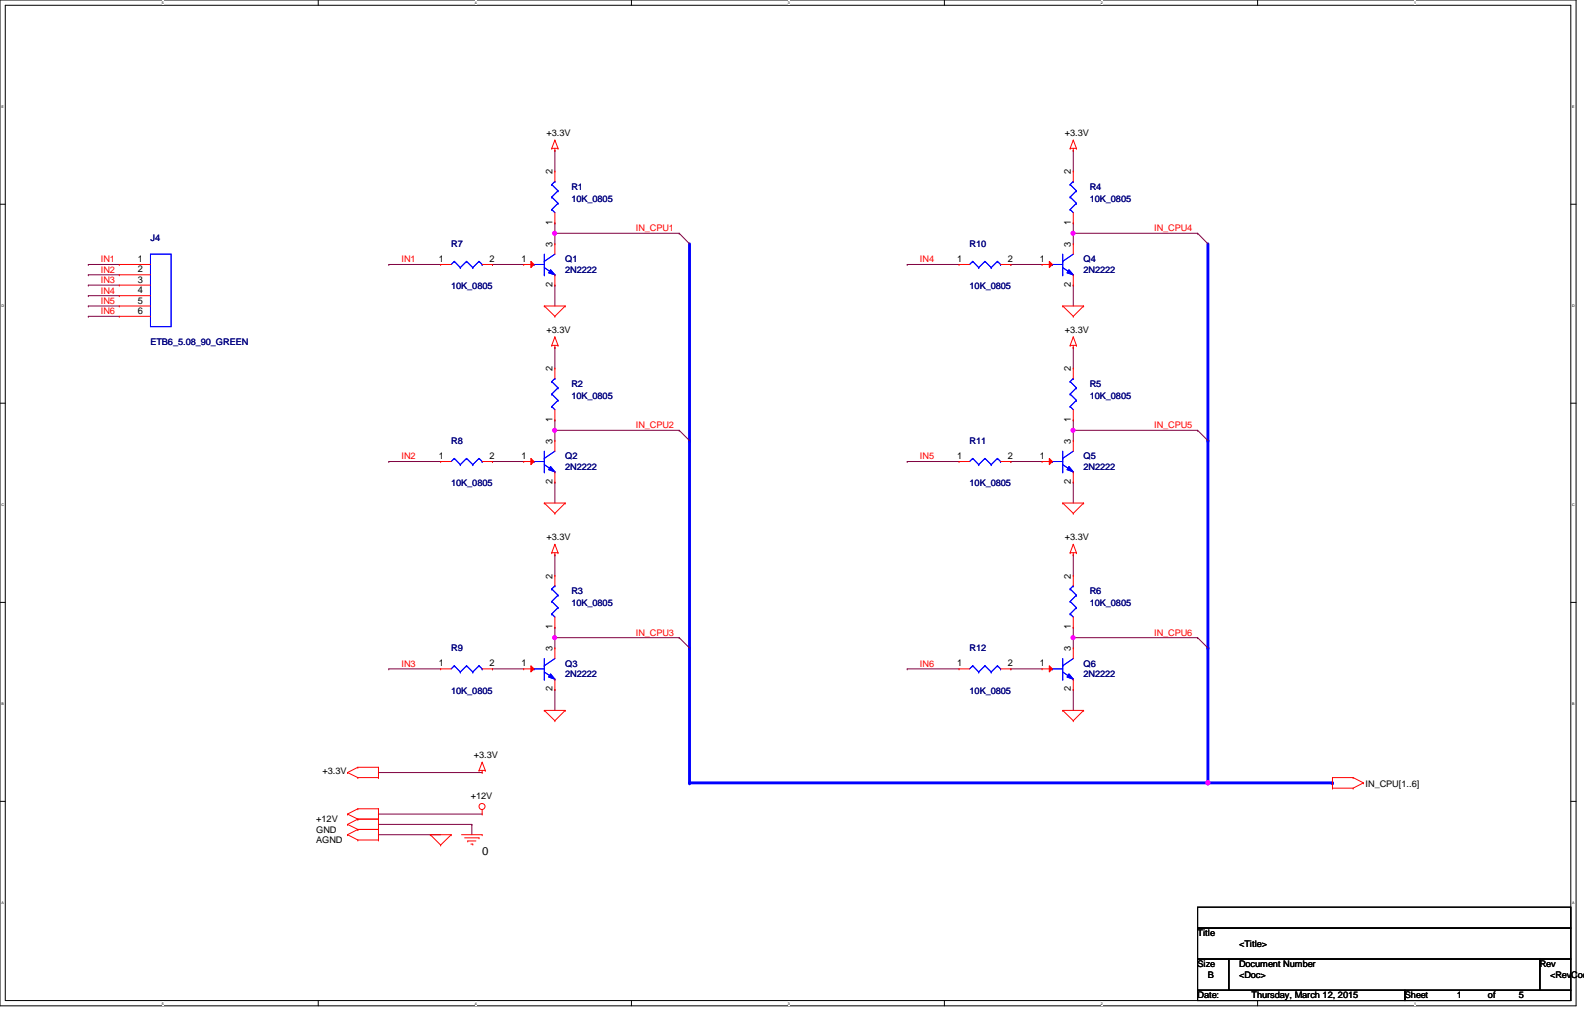
[picture p42: page 1]

0

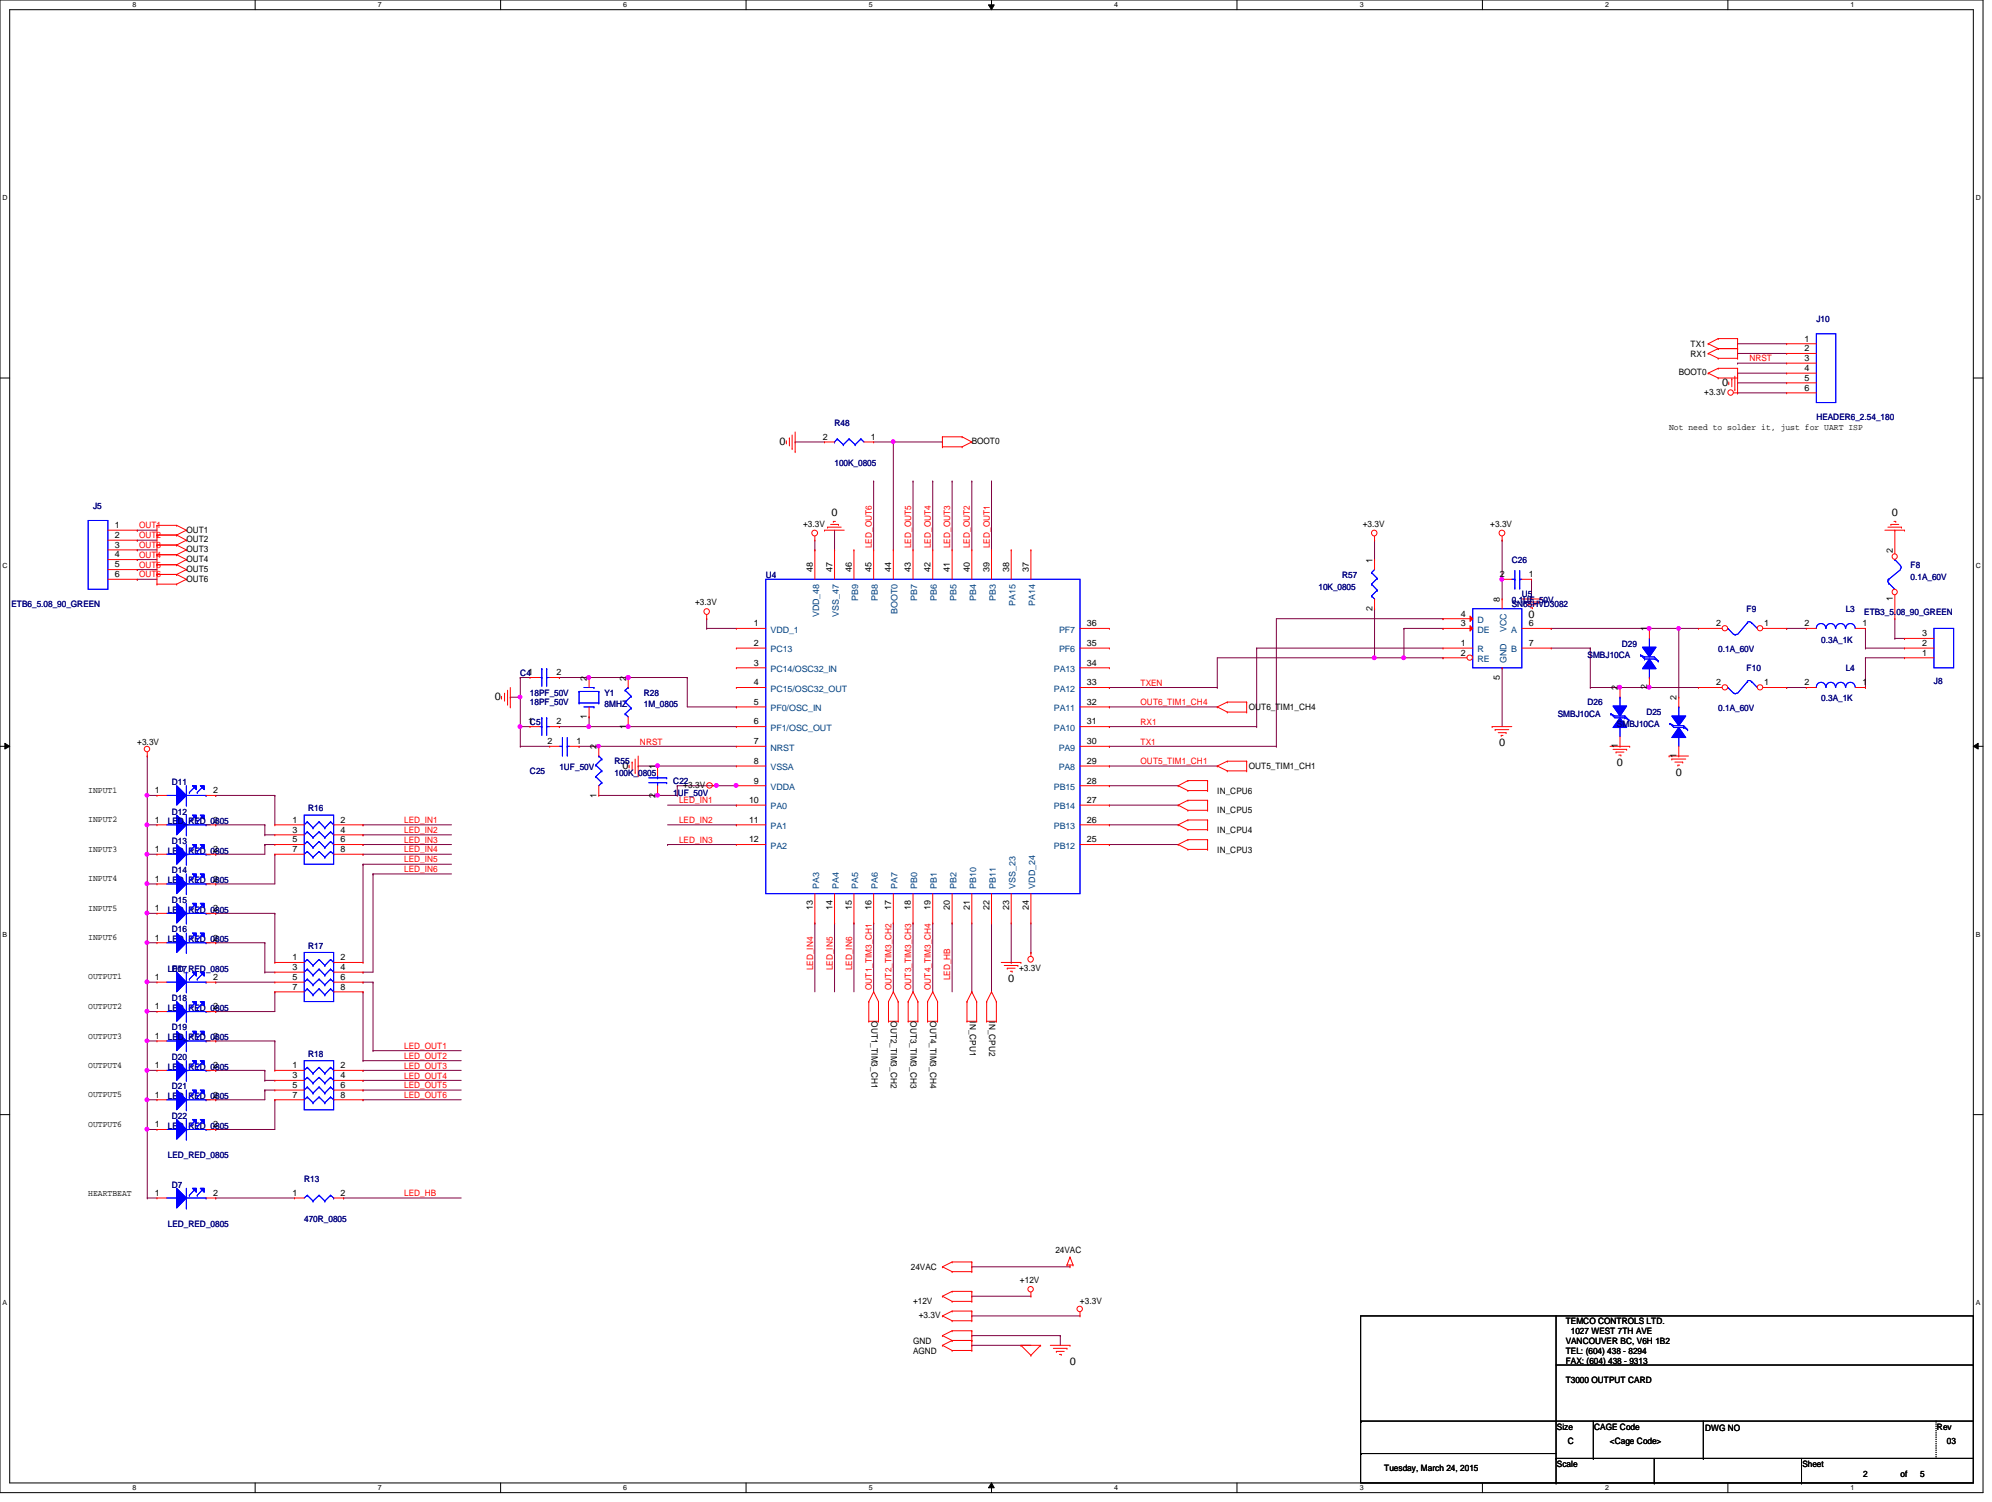
[picture p43: page 2]

Not need to solder it, just for UART ISP

# OUT1

# OUT2

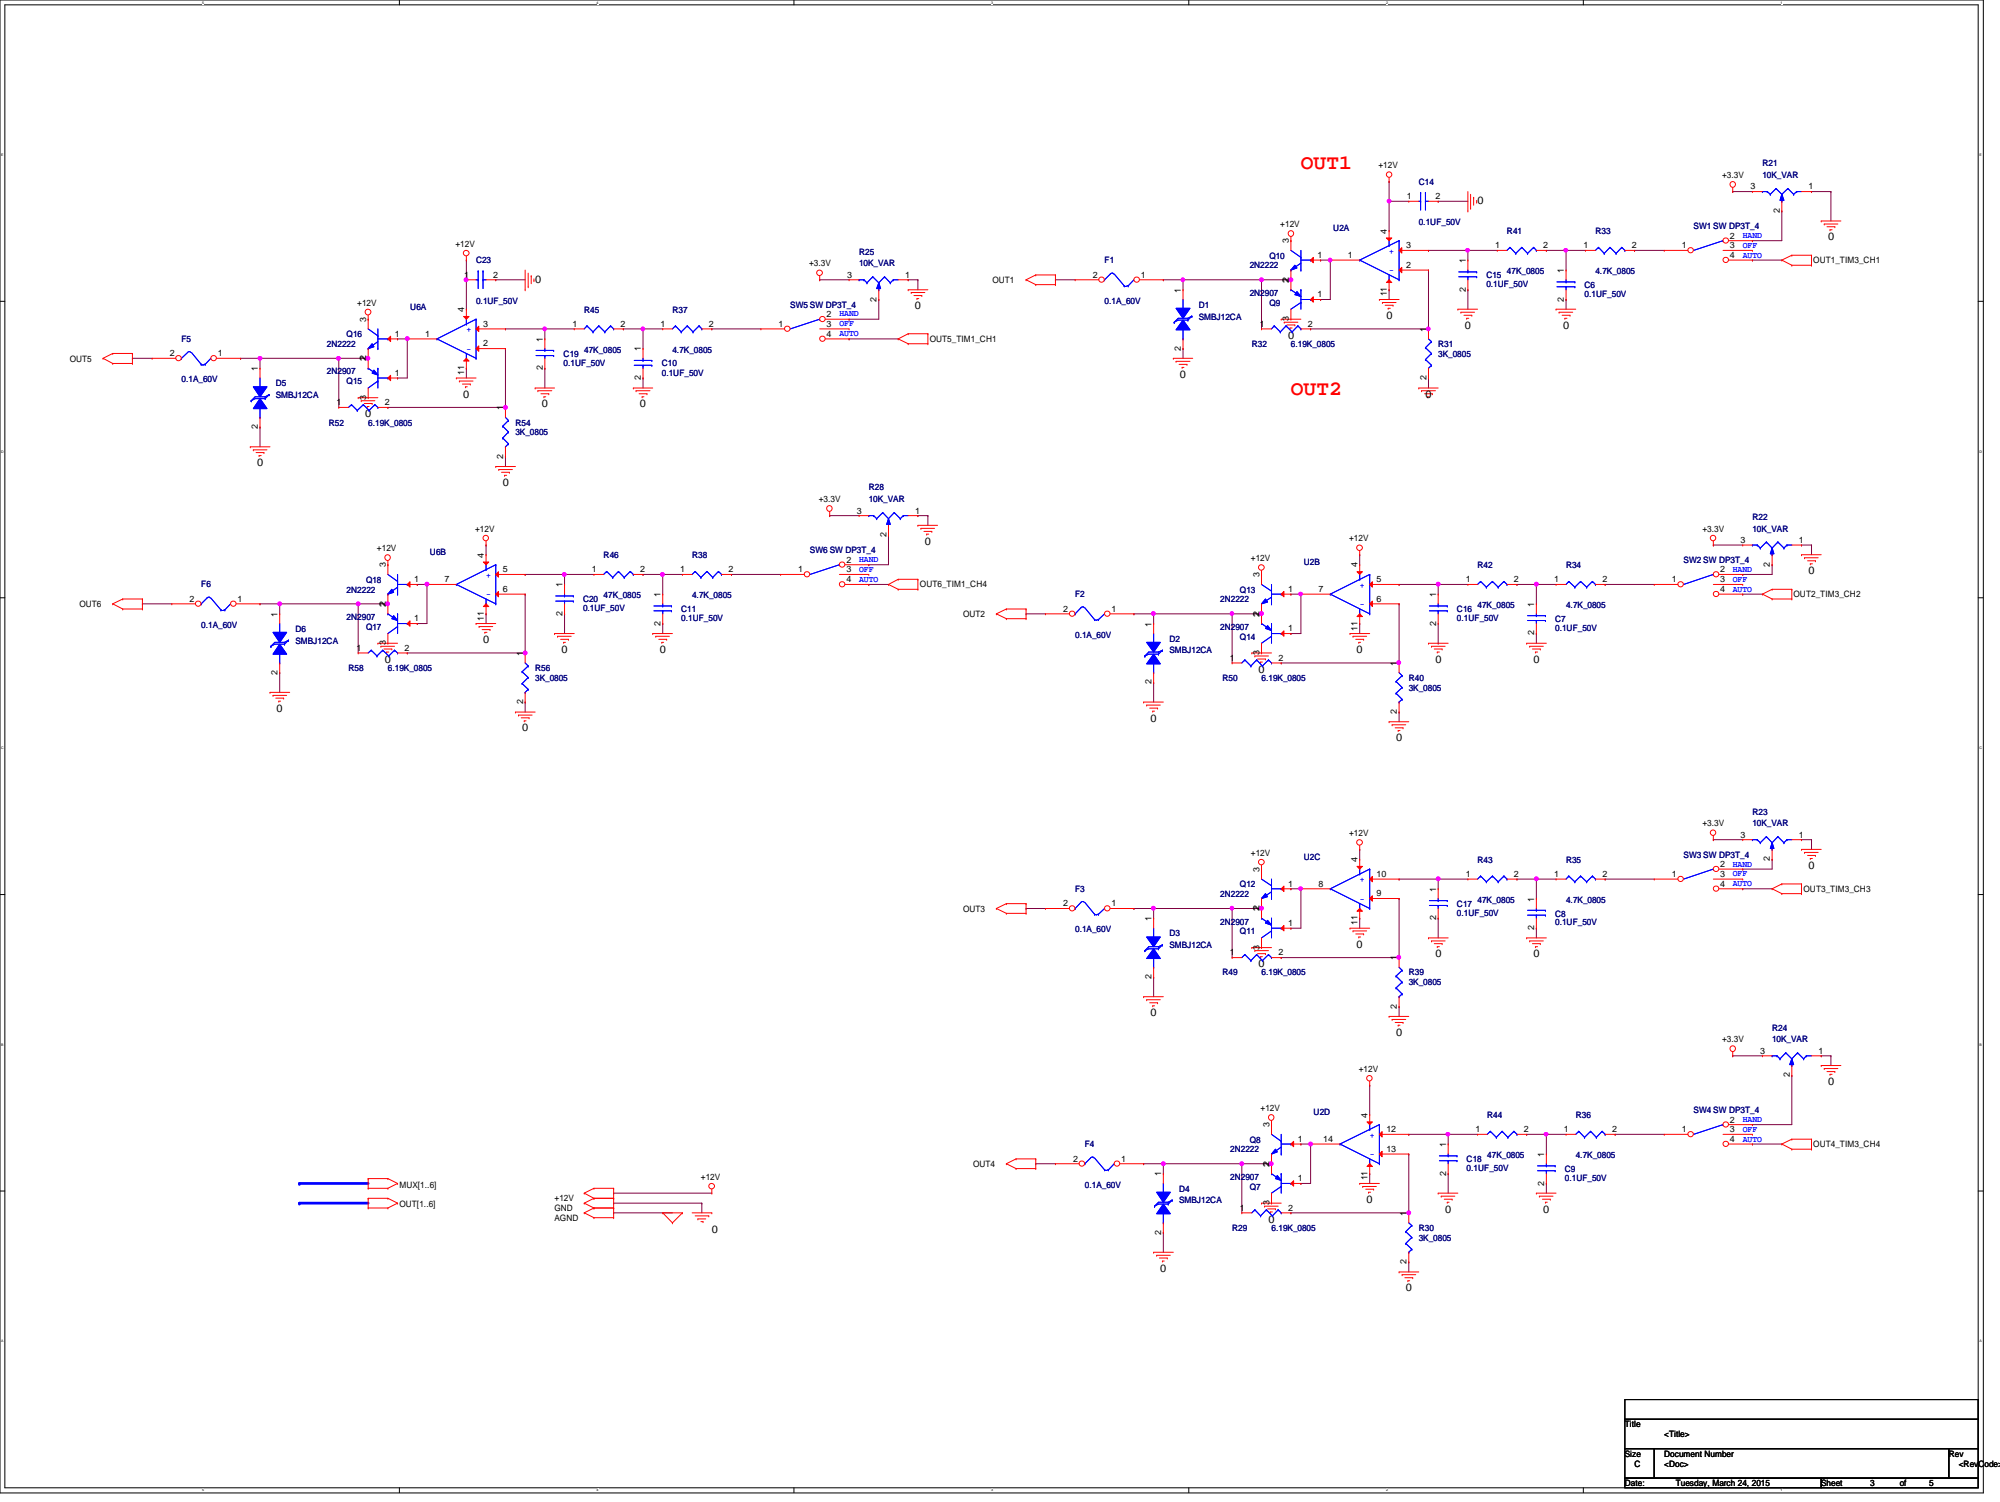
[picture p44: page 3]

# POWER

0

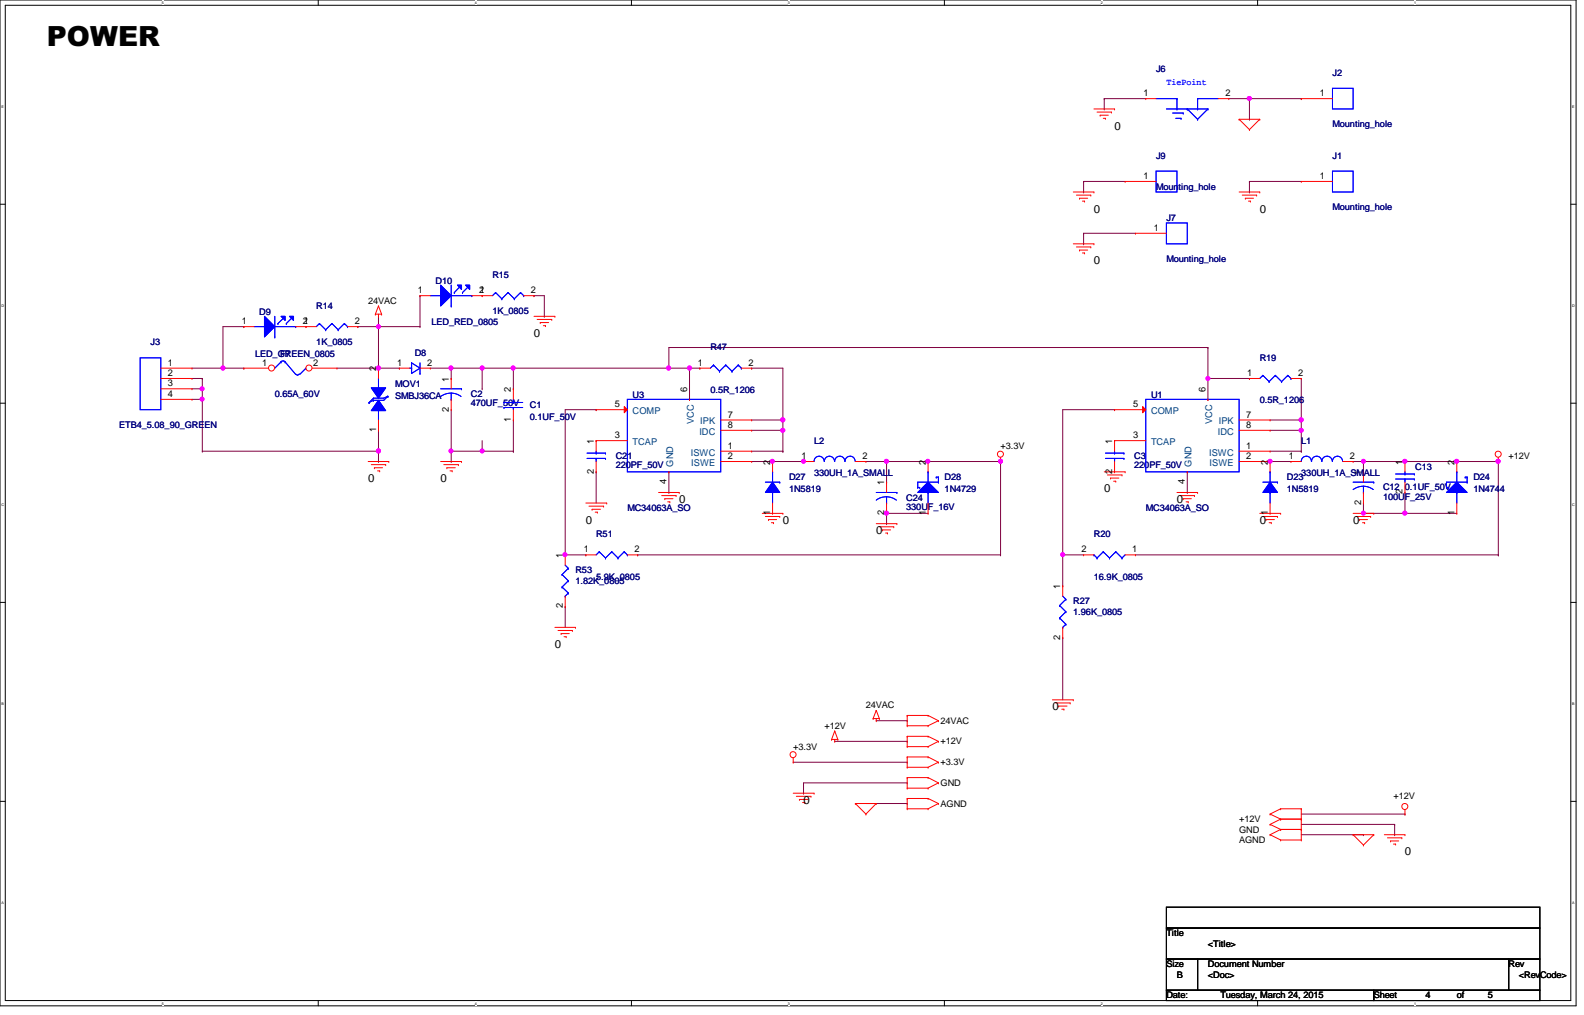
[picture p45: page 4]

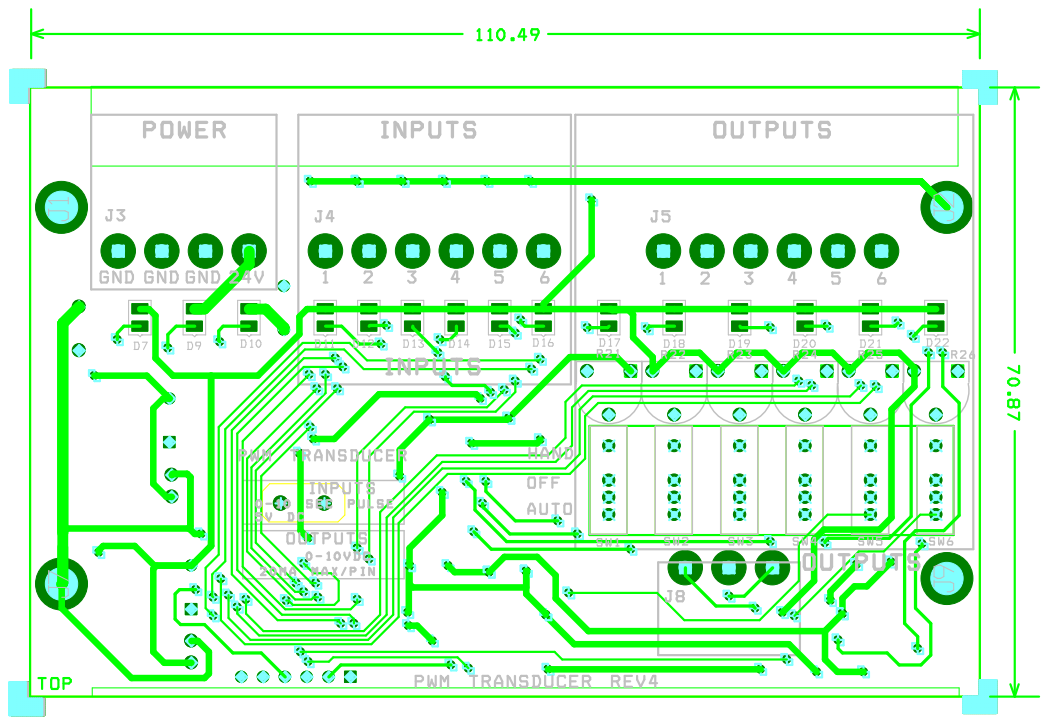
[picture p46: page 5]

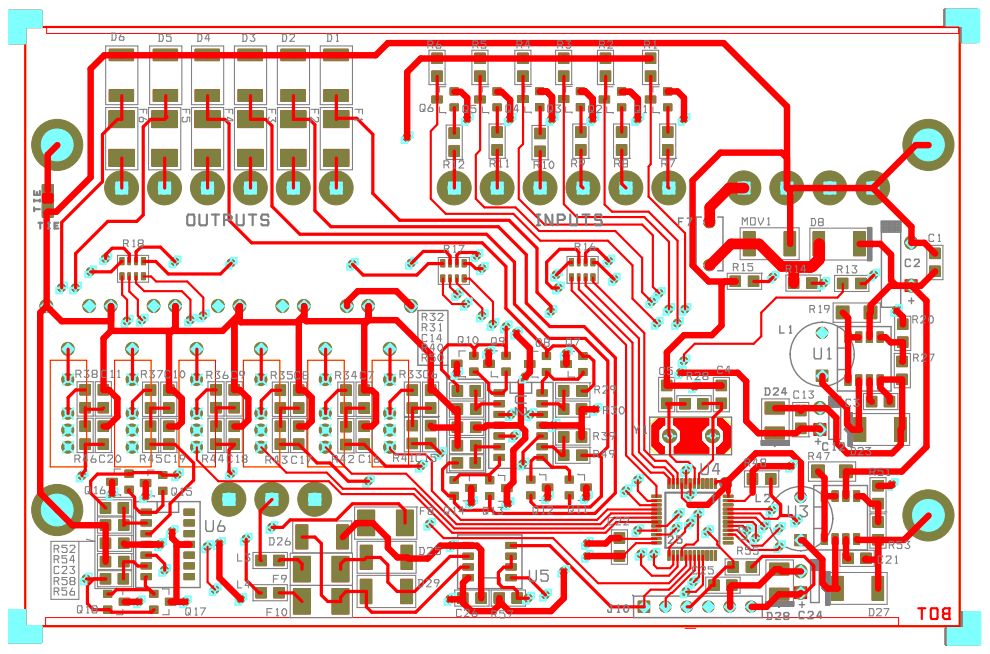
[picture p47: page 6]

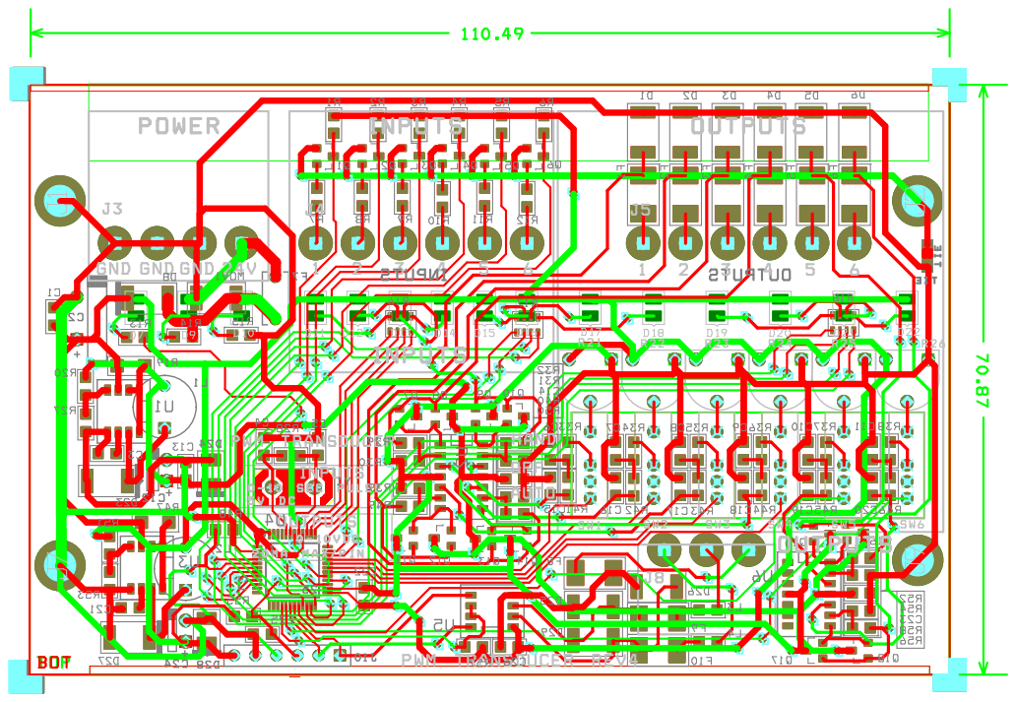
[picture p48: page 7]

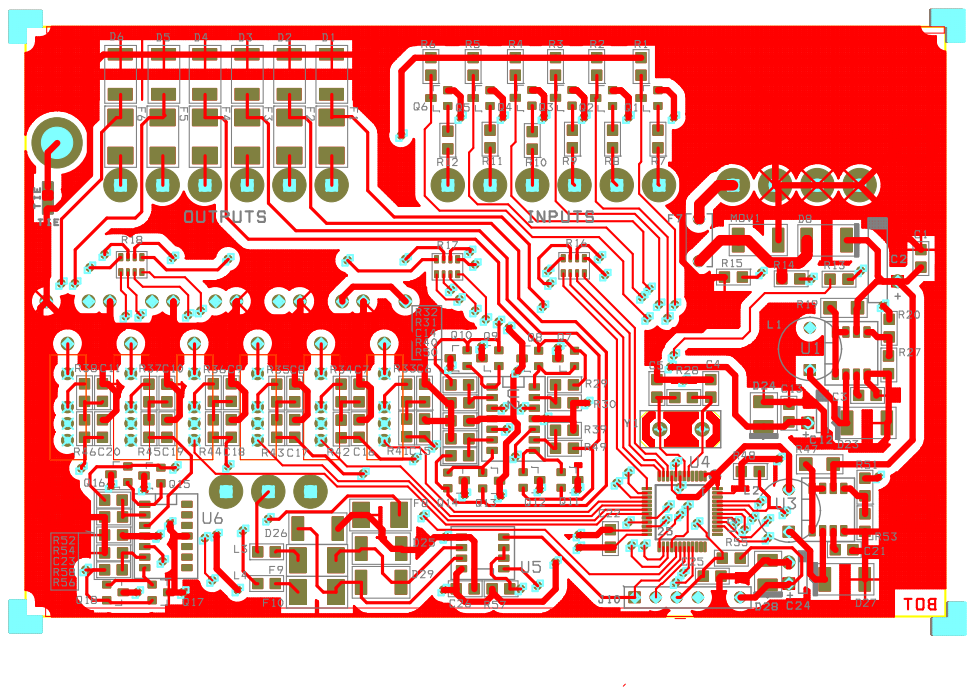
[picture p49: page 8]

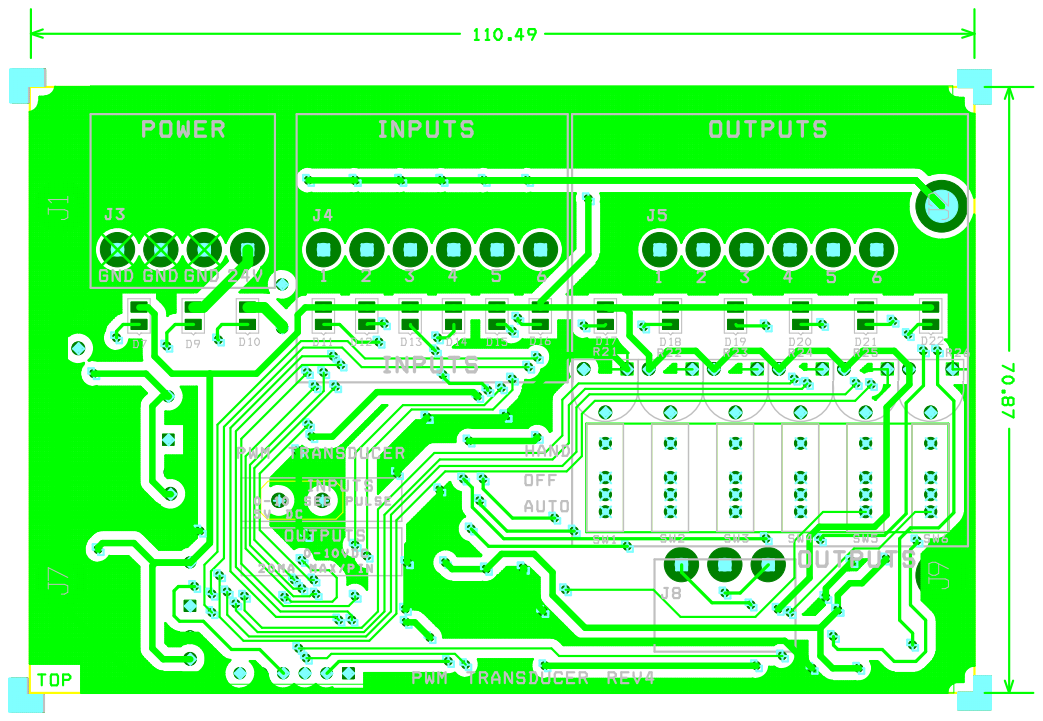
[picture p50: page 9]
