azuresky2019/Bacnet_Transducer/(list of files, drawings)

Other design files:
Hardware/PWM_Rev1/PWMREV1.DSN
Hardware/PWM_Rev2/PWMREV2.DSN
Hardware/PWM_Rev3/PWMREV3.DSN
Hardware/PWM_Rev3/pwmrev3.opj
Hardware/PWM_Rev4/New folder/PWMREV4.DSN
Hardware/PWM_Rev4/PWMREV4.DSN
Hardware/PWM_Rev4/pwmrev4.opj
Hardware/PWM_Rev5/pwmrev4.opj
Hardware/PWM_Rev5/PWMREV5.DSN
Hardware/PWM_Rev5/pwmrev5.opj
Hardware/PWM_Rev6/PWMREV6.DSN
Hardware/PWM_Rev6/pwmrev6.opj
Hardware/PWM_Rev7/pwmrev6.opj
Hardware/PWM_Rev7/PWMREV7.DSN
Hardware/PWM_Rev7/pwmrev7.opj
