azuresky2019/Bacnet_Transducer/Code/INPUT_LIB/inputs_control.c

#include "controls.h"
#include "modbus.h"


//#ifdef INPUT_CONTROL

Str_table_point			 custom_tab[MAX_TBLS];
Str_in_point             inputs[MAX_INS];

//uint8_t  input_type1[MAX_INS];

#define SENSOR_DELAY 10
#define FILTER_ADJUST 4
#define NO_TABLE_RANGES 16
#define MIDDLE_RANGE     8







const long  tab_int[10] = { 11875, 21375, 10000, 18000, 10000, 18000,10000, 18000, 10000, 18000 };

const long  limit[10][2] = { { -40000L, 150000L }, { -40000L, 302000L },
							{ -40000L, 120000L }, { -40000L, 248000L },
							{ -40000L, 120000L }, { -40000L, 248000L },
							{ -40000L, 120000L }, { -40000L, 248000L },
							{ -50000L, 110000L }, { -58000L, 230000L }
						  };

const uint16_t  def_tab[5][17] = {
 /* 3k termistor YSI44005 -40 to 150 Deg.C or -40 to 302 Deg.F */
	{ 233*4,  211*4, 179*4, 141*4, 103*4, 71*4, 48*4, 32*4,
		21*4, 14*4, 10*4, 7*4, 5*4, 4*4, 3*4, 2*4, 1*4 },

 /* 10k termistor GREYSTONE -40 to 120 Deg.C or -40 to 248 Deg.F */  // type2
	{ 988, 964, 924, 862, 778, 682, 572, 462,
	 364, 282, 214, 164, 128, 100, 76, 62, 48 },

 /* 3k termistor GREYSTONE -40 to 120 Deg.C or -40 to 248 Deg.F */
	{ 233*4, 215*4, 190*4, 160*4, 127*4, 96*4, 70*4, 50*4,
		35*4, 25*4, 18*4, 13*4, 9*4, 7*4, 5*4, 4*4, 3*4 },

 /* 10k termistor KM -40 to 120 Deg.C or -40 to 248 Deg.F */ // type3
	{ 976, 948, 906, 842, 764, 670, 566, 466,
		376, 296, 234, 180, 144, 114, 90, 76, 60 },

 /* 3k termistor AK -40 to 150 Deg.C or -40 to 302 Deg.F */
	{ 246*4, 238*4, 227*4, 211*4, 191*4, 167*4, 141*4, 115*4,
		92*4, 72*4, 55*4, 42*4, 33*4, 25*4, 19*4, 15*4, 12*4 }
};


uint32_t swap_double( uint32_t dat ) 	 //swap_double
{ 
	
	return dat;

}


uint16_t swap_word( uint16_t dat ) 	//	  swap_word
{ 
	return dat;
}


uint32_t get_input_value_by_range( uint8_t range, uint16_t raw )
{
	int index;
	long val;
	int work_var;
	int ran_in;
	int delta = MIDDLE_RANGE;
	uint16_t *def_tbl;
	Byte end = 0;
	range--;
	ran_in = range;
	range >>= 1;
	def_tbl = ( uint16_t * )&def_tab[range];

	if( raw <= def_tbl[NO_TABLE_RANGES] )
		return limit[ran_in][1];
	if( raw >= def_tbl[0] )
		return limit[ran_in][0];
	index = MIDDLE_RANGE;

	while( !end )
	{
		if( ( raw >= def_tbl[index] ) && ( raw <= def_tbl[index-1] ) )
		{
			index--;
			delta = def_tbl[index] - def_tbl[index+1];
			if( delta )
			{
				work_var = (int)( ( def_tbl[index] - raw ) * 100 );
				work_var /= delta;
				work_var += ( index * 100 );
				val = tab_int[ran_in];
				val *= work_var;
				val /= 100;
				val += limit[ran_in][0];
			}
			return val;
		}
		else
		{
			if( !delta )
				end = 1;
			delta /= 2;
			if( raw < def_tbl[index] )
				index += delta;
			else
				index -= delta;
			if( index <= 0 )
				return limit[ran_in][0];
			if( index >= NO_TABLE_RANGES )
				return limit[ran_in][1];
		}
	}
	
	return 0;
}


long test_match_custom( uint8_t range, uint16_t raw )
{   /* custom tables */

	Tbl_point *table_point;
	int index = 1;
	long val, diff;
	range -= table1;
	
	do
	{
		 table_point = &custom_tab[range].dat[index];
		 if( ( raw == swap_word(table_point->value) ) )
		 {
				return swap_double(table_point->unit);
		 }
		 if( ( raw < swap_word(table_point->value) ) &&
				( raw > swap_word((table_point-1)->value) ) )
			{ index--; break; }
		 else
			index++;
	}
	while( index <= 14 );

	table_point = &custom_tab[range].dat[index];
	index = swap_word((table_point+1)->value) - swap_word(table_point->value);
	if( index )
	{
/*		val = ( raw - table_point->value ) * 1000 /
			( (table_point+1)->value - table_point->value );*/
		val = ( raw - swap_word(table_point->value) );
		val *= 1000;
		val /= index;
	}
	diff = swap_double((table_point+1)->unit) - swap_double(table_point->unit);
	if( diff )
	{
/*		val = table_point->unit + val *
			( (table_point+1)->unit - table_point->unit );*/
		val *= diff;
		val /= 1000;
		val += swap_double(table_point->unit);
	}
	return val;
}


void control_input(void)
{
	Str_in_point *ins;
//	In_aux *inx;
	uint8_t point = 0;
	U32_T sample;
//	U8_T max_input;
  U8_T temp;	

	ins = inputs;
	while( point < MAX_INS )
	{		
		if(point < get_max_input())
		{			
			ins->sub_id = 0;
			ins->sub_product = 0;
			ins->sub_number = 0;			
			if(ins->auto_manual == 0)  // auto			 
			{ 				
				// raw value			
				if(ins->range != not_used_input)
				{				
					sample = get_input_raw(point);//input_raw[point];
					
					if( ins -> digital_analog == 0)  // digital
					{						
						temp = ins->decom;
						temp &= 0xf0;
						temp |= IN_NORMAL;
						ins->decom = temp;
						
						if( ins->range >= ON_OFF  && ins->range <= HIGH_LOW )  // control 0=OFF 1=ON
						{
							ins->control = (sample > 512 ) ? 1 : 0;
						}
						else
						{
							ins->control = (sample < 512 ) ? 0 : 1;					
						}
						if( ins->range >= custom_digital1 && ins->range <= custom_digital8 )
						{
							ins->control = (sample < 512 ) ? 0 : 1;	
						}
						//ins->value = ins->control ? 1000L : 0;
							
						sample = ins->control ? 1000L : 0;
					}
					else if(ins -> digital_analog == 1)	// analog
					{						
						
						temp = ins->decom;
						temp &= 0xf0;
						temp |= IN_NORMAL;
						ins->decom = temp;
						// add filter 
						//sample = Filter(point,sample);	
							
						switch(ins->range)
						{
						case Y3K_40_150DegC:
						case Y3K_40_300DegF:
						case R3K_40_150DegC:
						case R3K_40_300DegF:
						case R10K_40_120DegC:
						case R10K_40_250DegF:
						case KM10K_40_120DegC:
						case KM10K_40_250DegF:
						case A10K_50_110DegC:
						case A10K_60_200DegF:
							if(get_input_raw(point) > 1000)   
							{
								temp = ins->decom;
								temp &= 0xf0;
								temp |= IN_OPEN;
								ins->decom = temp;
							}
							else if(get_input_raw(point) < 20)  
							{ 
								temp = ins->decom;
								temp &= 0xf0;
								temp |= IN_SHORT;
								ins->decom = temp;
							}					
							sample = get_input_value_by_range( ins->range, sample );
							break;
						case V0_5:
							sample = conver_by_unit_5v(sample);		
							break;
						case V0_10_IN:
						
							sample = conver_by_unit_10v(sample);

							break;
						case I0_100Amps:
							sample = ( 100000L * sample ) >> 10;
							break;
						case I0_20ma:
							sample = ( 20000L * sample ) >> 10;
			
							break;
						case I0_20psi:
							sample = ( 20000L * sample ) >> 10;
							break;
						case N0_3000FPM_0_10V:
							sample = ( 2700000L * sample ) >> 10;
							break;
						case P0_100_0_5V:
							sample = ( 100000L * sample ) >> 10;
							break;
						case P0_100_4_20ma:
							sample = 100000L * ( sample - 255 ) / 768;
							break;
						case table1:
						case table2:
						case table3:
						case table4:
						case table5:
							conver_by_unit_custable(point,sample);

							sample = test_match_custom((int)ins->range, (int)sample);		
							sample = 1000 * sample;
							break;
						case N0_2_32counts:
						case HI_spd_count:	
	//						Test[11] = high_spd_counter[point];
	//						Test[12] = high_spd_counter_tempbuf[point];
							sample =  get_high_spd_counter(point)*1000;
						
							break;
						default:
							//	sample = sample * 1000;	
							break;
						}
				
					//	if( ins->calibration_increment ) 
						{
							if( !ins->calibration_sign )
								sample += 100L * (ins->calibration_hi * 256 + ins->calibration_lo);
							else
								sample += -100L * (ins->calibration_hi * 256 + ins->calibration_lo);
						}
					}
					ins->value = swap_double(sample);
				
				}

				else  // not_used_input
				{
					// if range is 0, show raw value
						temp = ins->decom;
						temp &= 0xf0;
						temp |= IN_NORMAL;
						ins->decom = temp;
//						ins->value = swap_double((U32_T)get_input_raw(point)/*input_raw[point]*/ * 1000);
						ins->value = (U32_T)get_input_raw(point)*3000/1023;
				}	
				
			}
		
	  } 
		else
		{
			ins->sub_id = 0;
			ins->sub_product = 0;
			ins->sub_number = 0;
			
			temp = ins->decom;
			temp &= 0xf0;
			temp |= IN_NORMAL;
			ins->decom = temp;
			
		}
		point++;
	  ins++;
		
	}
}
