azuresky2019/Bacnet_Transducer/Code/OUTPUT/output.c

#include "modbus.h"
#include "output.h"
#include "define.h"
#include "controls.h"
#include "timerx.h"

//the output voltage and output led is control the pwm 
void output_init(void)
{ 
	
	GPIO_InitTypeDef GPIO_InitStructure;
	TIM_TimeBaseInitTypeDef TIM_TimeBaseStructure;
	TIM_OCInitTypeDef TIM_OCInitStructure;

	/********************************************************************************************/
	/*************************** output voltage 6 pins******************************************/
	RCC_APB1PeriphClockCmd(RCC_APB1Periph_TIM4, ENABLE);
	RCC_APB2PeriphClockCmd(RCC_APB2Periph_GPIOD | RCC_APB2Periph_AFIO, ENABLE);
	GPIO_PinRemapConfig(GPIO_Remap_TIM4, ENABLE); //TIM3_CH1->PC6, TIM3_CH2->PC7, TIM3_CH3->PC8, TIM3_CH4->PC9	
	GPIO_InitStructure.GPIO_Pin = GPIO_Pin_12 | GPIO_Pin_13 | GPIO_Pin_14 | GPIO_Pin_15;  //TIM3_CH1-4
	GPIO_InitStructure.GPIO_Mode = GPIO_Mode_AF_PP;
	GPIO_InitStructure.GPIO_Speed = GPIO_Speed_50MHz;
	GPIO_Init(GPIOD, &GPIO_InitStructure);
	
	RCC_APB1PeriphClockCmd(RCC_APB1Periph_TIM5, ENABLE);
	RCC_APB2PeriphClockCmd(RCC_APB2Periph_GPIOA|RCC_APB2Periph_AFIO, ENABLE);	
	GPIO_InitStructure.GPIO_Pin = GPIO_Pin_0 | GPIO_Pin_1 ;  
	GPIO_InitStructure.GPIO_Mode = GPIO_Mode_AF_PP;
	GPIO_InitStructure.GPIO_Speed = GPIO_Speed_50MHz;
	GPIO_Init(GPIOA, &GPIO_InitStructure);

	
	TIM_TimeBaseStructure.TIM_Period = 1000;
	TIM_TimeBaseStructure.TIM_Prescaler = 0;
	TIM_TimeBaseStructure.TIM_ClockDivision = 0;
	TIM_TimeBaseStructure.TIM_CounterMode = TIM_CounterMode_Up;
	TIM_TimeBaseInit(TIM5, &TIM_TimeBaseStructure);
	
	TIM_TimeBaseStructure.TIM_Period = 1000;
	TIM_TimeBaseStructure.TIM_Prescaler = 0;
	TIM_TimeBaseStructure.TIM_ClockDivision = 0;
	TIM_TimeBaseStructure.TIM_CounterMode = TIM_CounterMode_Up;
	TIM_TimeBaseInit(TIM4, &TIM_TimeBaseStructure);
	
	
	TIM_OCInitStructure.TIM_OCMode = TIM_OCMode_PWM2;
	TIM_OCInitStructure.TIM_OutputState = TIM_OutputState_Enable;
	TIM_OCInitStructure.TIM_OCPolarity = TIM_OCPolarity_Low;
	
	TIM_OC1Init(TIM5, &TIM_OCInitStructure);
	TIM_OC2Init(TIM5, &TIM_OCInitStructure);

	TIM_OC1Init(TIM4, &TIM_OCInitStructure);
	TIM_OC2Init(TIM4, &TIM_OCInitStructure);
	TIM_OC3Init(TIM4, &TIM_OCInitStructure);
	TIM_OC4Init(TIM4, &TIM_OCInitStructure);
	

	
	TIM_OC1PreloadConfig(TIM5, TIM_OCPreload_Enable);
	TIM_OC2PreloadConfig(TIM5, TIM_OCPreload_Enable);

	

	
	TIM_OC1PreloadConfig(TIM4, TIM_OCPreload_Enable);
	TIM_OC2PreloadConfig(TIM4, TIM_OCPreload_Enable);
	TIM_OC3PreloadConfig(TIM4, TIM_OCPreload_Enable);
	TIM_OC4PreloadConfig(TIM4, TIM_OCPreload_Enable);

	TIM_Cmd(TIM5, ENABLE);
	TIM_Cmd(TIM4, ENABLE);
}

void led_output_init(void)
{ 
	
	GPIO_InitTypeDef GPIO_InitStructure;
	TIM_TimeBaseInitTypeDef TIM_TimeBaseStructure;
	TIM_OCInitTypeDef TIM_OCInitStructure;
	/*************************** output led 6 pins******************************************/
	RCC_APB1PeriphClockCmd(RCC_APB1Periph_TIM3, ENABLE);
	RCC_APB2PeriphClockCmd(RCC_APB2Periph_GPIOC | RCC_APB2Periph_AFIO, ENABLE);
	GPIO_PinRemapConfig(GPIO_FullRemap_TIM3, ENABLE); //TIM3_CH1->PC6, TIM3_CH2->PC7, TIM3_CH3->PC8, TIM3_CH4->PC9	
	GPIO_InitStructure.GPIO_Pin = GPIO_Pin_6 | GPIO_Pin_7 | GPIO_Pin_8 | GPIO_Pin_9;  //TIM3_CH1-4
	GPIO_InitStructure.GPIO_Mode = GPIO_Mode_AF_PP;
	GPIO_InitStructure.GPIO_Speed = GPIO_Speed_50MHz;
	GPIO_Init(GPIOC, &GPIO_InitStructure);	
	
	RCC_APB1PeriphClockCmd(RCC_APB1Periph_TIM2, ENABLE);
	RCC_APB2PeriphClockCmd(RCC_APB2Periph_GPIOB|RCC_APB2Periph_AFIO, ENABLE);
	GPIO_PinRemapConfig(GPIO_FullRemap_TIM2 , ENABLE);
	GPIO_InitStructure.GPIO_Pin = GPIO_Pin_10 | GPIO_Pin_11  ;  
	GPIO_InitStructure.GPIO_Mode = GPIO_Mode_AF_PP;
	GPIO_InitStructure.GPIO_Speed = GPIO_Speed_50MHz;
	GPIO_Init(GPIOB, &GPIO_InitStructure);


	TIM_TimeBaseStructure.TIM_Period = 50000;
	TIM_TimeBaseStructure.TIM_Prescaler = 0;
	TIM_TimeBaseStructure.TIM_ClockDivision = 0;
	TIM_TimeBaseStructure.TIM_CounterMode = TIM_CounterMode_Up;
	TIM_TimeBaseInit(TIM2, &TIM_TimeBaseStructure);
	
	
	TIM_TimeBaseStructure.TIM_Period = 50000;
	TIM_TimeBaseStructure.TIM_Prescaler = 0;
	TIM_TimeBaseStructure.TIM_ClockDivision = 0;
	TIM_TimeBaseStructure.TIM_CounterMode = TIM_CounterMode_Up;
	TIM_TimeBaseInit(TIM3, &TIM_TimeBaseStructure);
	
	
	
	TIM_OCInitStructure.TIM_OCMode = TIM_OCMode_PWM2;
	TIM_OCInitStructure.TIM_OutputState = TIM_OutputState_Enable;
	TIM_OCInitStructure.TIM_OCPolarity = TIM_OCPolarity_Low;
	
	
	TIM_OC1Init(TIM3, &TIM_OCInitStructure);
	TIM_OC2Init(TIM3, &TIM_OCInitStructure);
	TIM_OC3Init(TIM3, &TIM_OCInitStructure);
	TIM_OC4Init(TIM3, &TIM_OCInitStructure);

	TIM_OC3Init(TIM2, &TIM_OCInitStructure);
	TIM_OC4Init(TIM2, &TIM_OCInitStructure);

	


	
	TIM_OC3PreloadConfig(TIM2, TIM_OCPreload_Enable);
	TIM_OC4PreloadConfig(TIM2, TIM_OCPreload_Enable);
	

	TIM_OC1PreloadConfig(TIM3, TIM_OCPreload_Enable);
	TIM_OC2PreloadConfig(TIM3, TIM_OCPreload_Enable);
	TIM_OC3PreloadConfig(TIM3, TIM_OCPreload_Enable);
	TIM_OC3PreloadConfig(TIM3, TIM_OCPreload_Enable);
	
	TIM_Cmd(TIM3, ENABLE);
	TIM_Cmd(TIM2, ENABLE);
}
void set_output (TIM_TypeDef* TIMx, u8 channel, u16 duty)
{
	u16 compare_value = duty;
	// calculate the compare value and then set it to change the pwm duty
	
	switch(channel)
	{
		case 1:
			TIM_SetCompare1(TIMx, compare_value);
		break;
		case 2:
			TIM_SetCompare2(TIMx, compare_value);
		break;
		case 3:
			TIM_SetCompare3(TIMx, compare_value);
		break;
		case 4:
			TIM_SetCompare4(TIMx, compare_value);
		break;
	}
}

const struct
{
	TIM_TypeDef* TIMx ;
	u8 chip_channel ;

} AO_CONFIG[12] = 
{
	{TIM4, 4},
	{TIM4, 3},
	{TIM4, 2},
	{TIM4, 1},
	{TIM5, 1},
	{TIM5, 2},
	{TIM3, 1},
	{TIM3, 2},
	{TIM3, 3},
	{TIM3, 4},
	{TIM2, 3},
	{TIM2, 4},	
};

	
void output_refresh(void)
{
	 uint8_t loop = 0 ;
	for(loop = 0 ; loop<6; loop++)
	{
		if(refresh_flag[loop] == 1)
		{
			set_output(AO_CONFIG[loop].TIMx, AO_CONFIG[loop].chip_channel,  output_value[loop]/10);		//control output 
			set_output(AO_CONFIG[loop+6].TIMx, AO_CONFIG[loop+6].chip_channel,  (50000-(output_value[loop]-1)*5));	
			refresh_flag[loop] = 0 ;
		}
			//control output led 
	}
}
