azuresky2019/Bacnet_Transducer/Code/HARDWARE/LED/led.h

#ifndef __LED_H
#define __LED_H
 
#include "bitmap.h"


#define LED_ON	0
#define LED_OFF	1	

#define HB	PEout(6)// DS1
#define LED0	PEout(0)// DS1
#define LED1	PEout(1)// DS1
#define LED2	PEout(2)// DS1
#define LED3	PEout(3)// DS1
#define LED4	PEout(4)// DS1
#define LED5	PEout(5)// DS1

#define PIN_TEST	PAout(14)// DS1
//#define LED2	PCout(4)// DS2
//#define LED3	PCout(5)// DS3

//// DS0
//#define LED0_OFF()	GPIO_SetBits(GPIOB, GPIO_Pin_10);
//#define LED0_ON()	GPIO_ResetBits(GPIOB, GPIO_Pin_10);
//// DS1
//#define LED1_OFF()	GPIO_SetBits(GPIOB, GPIO_Pin_11);
//#define LED1_ON()	GPIO_ResetBits(GPIOB, GPIO_Pin_11);
//// DS2
//#define LED2_OFF()	GPIO_SetBits(GPIOC, GPIO_Pin_4);
//#define LED2_ON()	GPIO_ResetBits(GPIOC, GPIO_Pin_4);
//// DS3
//#define LED3_OFF()	GPIO_SetBits(GPIOC, GPIO_Pin_5);
//#define LED3_ON()	GPIO_ResetBits(GPIOC, GPIO_Pin_5);


void LED_Init(void);
void tabulate_LED_STATE(void);
void refresh_led(void);
//extern u8 dim_time_setting[28] ;	 				    
#endif
