azuresky2019/Bacnet_Transducer/Code/OUTPUT/output.h

#ifndef _OUTPUT_H_
#define _OUTPUT_H_

#include "bitmap.h"
#include "stm32f10x_adc.h"


void update_digit_output(void) ;
void output_init(void) ;
void led_output_init(void) ;
void output_refresh(void) ;
void set_output (TIM_TypeDef* TIMx, u8 channel, u16 duty);














#endif
